Naveen-kumar14/CanScope/TASK.md

# CANScope task log

Canonical task file: `TASK.md` (no `task.md` existed; only this file is used).

## Current status

- Phase: phase 1 (repository foundation) **software-complete** as of 2026-10-13. Next phase: Stage 0/1 hardware inventory and evidence.
- Overall state: all firmware targets build, and the host and dashboard tests pass. **No hardware or protocol value is verified.** Node 3 is blocked on its pin map and role.
- Git: local repo on branch `main`, tracking `origin` = https://github.com/Naveen-kumar14/CanScope.git (see the 2026-10-13 Git entry).
- 2026-10-17: protocol v1, Node 1/2 ECU firmware, Node 3 monitor firmware (OLED/LEDs/buttons/buzzer) and the Web Serial dashboard implemented; all builds and tests pass; **not yet flashed or run on hardware**. See the 2026-10-17 entry and docs/physical-integration.md.
- 2026-10-16: physical build documentation **Rev 2.0-draft (NOT FINAL)**: canonical wiring ledger, corrected manual PDF, build video. Q1 buzzer transistor pinout BLOCKED; all other wires PROVISIONAL pending bench gates G1-G14. See the 2026-10-16 entry.

---

## 2026-10-13 — Session 1, discovery note (written before implementation)

### Repository state found

- Path: `E:\2nd year\Embedded systems Package` (used as repository root, no nested `CANScope/` folder created).
- Git: **not a Git repository** (`git status` → `fatal: not a git repository`). No commits will be made this session; `git init` is left as a user decision.
- Existing files (all preserved unchanged):
  - `CANScope_ESP32_Project_Brief.md` — project brief, status legend, candidate pin maps, test stages.
  - `CANScope_Claude_Repository_Implementation_Task.md` — repository implementation task.
  - `sketch_node1_test/sketch_node1_test.ino`
  - `sketch_node2_test/sketch_node2_test.ino`
  - `sketch_oct07a/sketch_oct07a.ino`

### What the existing sketches do (observed from source only, never run by Claude)

| Sketch | Observed behaviour | CAN settings in the source |
|---|---|---|
| `sketch_node1_test` | Installs and starts the ESP32 TWAI driver, prints success/failure. `loop()` is empty: it does not read frames, but in NORMAL mode the controller will ACK frames on the bus. | TX `GPIO17`, RX `GPIO16`, 500 kbit/s, `TWAI_MODE_NORMAL`, accept-all filter |
| `sketch_node2_test` | "Battery ECU Node 2" test transmitter. Every 1000 ms sends `0x201` (uint16 BE raw 480), `0x202` (int16 BE raw 120), `0x203` (uint8 raw 85); every 500 ms sends heartbeat `0x210` (uint8 1). Values are hard-coded constants, not sensor readings. Units/scaling are not stated anywhere. | TX `GPIO17`, RX `GPIO16`, 500 kbit/s, `TWAI_MODE_NORMAL`, standard 11-bit IDs (flags left zero) |
| `sketch_oct07a` | Serial "hello world": prints `CANScope ESP32 Ready!` every second. No CAN. | none |

Note: the sketches use GPIO17/GPIO16, while the brief's candidate map uses GPIO22/GPIO21. Neither is verified on hardware. GPIO16/17 are used for PSRAM on ESP32-WROVER modules, so the board variant matters.

### Toolchains detected

- Node.js v24.16.0, npm 11.13.0 → dashboard (Vite + React + TypeScript + Vitest planned).
- Python 3.14.2, g++ 15.2.0 (MinGW-w64), CMake 4.2.0, Ninja, mingw32-make → host-side firmware unit tests.
- **No ESP32 toolchain installed** (no arduino-cli, PlatformIO, ESP-IDF). Plan: install PlatformIO into an isolated venv in the session scratchpad (not global) and attempt ESP32 builds.

### Unverified hardware/protocol values (nothing new verified this session so far)

ESP32 board variants; transceiver part and 3.3 V compatibility; standby/silent pin wiring; Node 3 role, sensors, I/O; final CAN TX/RX GPIOs for every node; Classical CAN vs CAN FD; nominal bit rate (500 kbit/s appears in legacy sketches only); standard vs extended IDs; production CAN IDs and payloads; termination locations; dashboard transport and deployment.

### Planned scope for this session

1. Repository skeleton, `.gitignore`, README, docs (architecture, hardware status, testing, Node 3 pin map, CAN ID registry).
2. Shared firmware library (config + validation, raw frame model + serial JSON-line encoder, protocol registry/decoder, TWAI transport with TX gate, diagnostics banner) as PlatformIO libraries under `firmware/common/`.
3. PlatformIO targets: `node1`, `node2`, `node3`, `monitor`, plus `legacy` environments in node1/node2 that compile the existing sketches **unchanged** (included by path) as a regression check.
4. Host unit tests (CMake + g++) for config validation, frame model, decoder.
5. Read-only dashboard with mock data source, transport-neutral adapter, tests.
6. Run all available checks and record exact results here.

---

## 2026-10-13 — Session 1, implementation results

### Summary

Built the phase-1 foundation around the existing work: shared firmware libraries, four PlatformIO targets plus regression builds of the two legacy sketches, host unit tests, a read-only mock-data dashboard, and documentation. Every software check passes. Nothing hardware-related was tested.

### Work completed

- Repository skeleton, `.gitignore` (build outputs, secrets, `captures/private/`), `README.md`.
- `firmware/common` libraries:
  - `can_config`: config model and validation.
  - `frame_capture`: `RawFrame` and a bounded JSON-line encoder.
  - `can_transport`: interface, TX gate, status JSON, and `TwaiTransport` for ESP32 (listen-only/normal/no-ack, alerts, error counters, bus-off counting, explicit-only recovery).
  - `protocol_decoder`: empty production registry, plus the UNVERIFIED legacy test-sketch registry.
  - `diagnostics`: start-up banner.
  - `node_runtime`: shared ESP32 setup/loop.
- Targets:
  - `firmware/node1` (`node1`, `legacy_sketch`) and `firmware/node2` (`node2`, `legacy_sketch`): normal mode, TX disabled.
  - `firmware/node3` (`node3`): all CAN values UNVERIFIED, so it refuses to start CAN. Has placeholder sections for sensors, inputs, outputs and application messages.
  - `firmware/monitor` (`monitor`): listen-only, TX disabled.
- Host tests (`test/`, CMake + g++ with `-Werror`): config validation, raw frame/JSON, TX gate/status, banner, decoder (EXAMPLE data).
- Dashboard (`dashboard/`, Vite 8 + React 19 + TS 6 + Vitest 5 + ESLint 10):
  - transport-neutral `CanDataSource` (no send method)
  - mock source with 6 scenarios
  - serial-line parser for the firmware JSON lines
  - decoder (decoded/unverified/unknown/mismatch)
  - status bar with READ-ONLY and MOCK badges
  - bus summary (state, frame rate, RX/TX/error/bus-off/missed counters)
  - node health cards (Node 3 included)
  - filters (ID, node, time range)
  - frame table and frame detail
  - loading/empty/stale/disconnected/error states
- Docs: `docs/architecture.md`, `docs/hardware-status.md`, `docs/testing.md`, `docs/wiring/node-3-pin-map.md`, `docs/protocol/can-id-registry.md`, `dashboard/README.md`, `tools/README.md`, `test/integration/README.md`.
- Tools: `tools/run-host-tests.sh`, `tools/build-firmware.sh`.

### Files changed

All new (nothing existing was modified): `.gitignore`, `README.md`, `TASK.md`, `captures/.gitkeep`, `docs/**`, `firmware/**`, `dashboard/**` (excluding `node_modules`/`dist`), `test/**`, `tools/**`.

### Existing files preserved (unchanged; SHA-256 recorded 2026-10-13 after the session's work)

```
47a1f6f909a73373c137a00b1bbfa89a24ec637cac8b219b4166601a146bd248  sketch_node1_test/sketch_node1_test.ino
cb46f039dfccee47f8f14869fbaa3764d24421f23439c87085f605a9f451ec76  sketch_node2_test/sketch_node2_test.ino
9d1d708889231af702a1911dbd04e29093a731fc3bfaa9fa46c486f1d1901289  sketch_oct07a/sketch_oct07a.ino
56087058ca20f9494d81bf489a96d00ede10a9634ad793d4a30d34e5812a5fe8  CANScope_Claude_Repository_Implementation_Task.md
5dd6150b1daaee2500ad7d59633bb8cc32688d90ea1ffb959424b24a40516052  CANScope_ESP32_Project_Brief.md
```

Hashes were not taken before the session. No tool in this session wrote to these files; they were only read, or `#include`d by the legacy build wrappers.

### Environment changes outside the repository

- PlatformIO Core 6.2.0 installed in a venv in the Claude session scratchpad (temporary; not on the user's PATH).
- PlatformIO packages (espressif32 6.12.0, Arduino-ESP32, xtensa toolchain) downloaded to **`C:\canscope-pio`** (`PLATFORMIO_CORE_DIR`). The first attempt, with the core dir inside the long scratchpad path, failed with `PackageException: Could not install package 'espressif32 @ 6.12.0'` because unpacked paths exceeded the Windows 260-character limit. `C:\canscope-pio` is safe to delete; PlatformIO will download again.
- `dashboard/node_modules` installed by `npm install` (ignored by git).

### Commands and exact results

| Command | Result |
|---|---|
| `sh tools/run-host-tests.sh` (clean `build/host-tests`) | **5/5 test suites passed** (test_can_config, test_raw_frame, test_can_transport, test_diagnostics, test_protocol_decoder). Compiled with `-Wall -Wextra -Werror` |
| `pio run -d firmware/node3 -e node3` (first build) | SUCCESS. One `-Wcomment` warning in `node3_hw_config.h` (trailing backslash in a comment), fixed afterwards |
| `sh tools/build-firmware.sh` (`PLATFORMIO_CORE_DIR=C:/canscope-pio`) | **6/6 SUCCESS, 0 warnings in project sources**: node1/node1, node1/legacy_sketch, node2/node2, node2/legacy_sketch, node3/node3, monitor/monitor. Shared-runtime targets: RAM 6.6% (21,648 B), flash 21.5% (~281 KB). Legacy: RAM 6.6%, flash 20.8–20.9% |
| First `sh tools/build-firmware.sh` attempt | exit 127 `pio: command not found`. My PATH used `C:/...` form, which POSIX PATH can't parse. Not a script defect |
| `npm run check` (dashboard) | typecheck OK, eslint OK, **Vitest 34/34 passed (5 files)**, `vite build` OK (JS 241 kB / 75 kB gzip) |
| First Vitest run | 1 failure in the read-only test: its regex matched the footer disclaimer text. Test rewritten to assert the exact set of interactive controls (no buttons/links/forms; one ID textbox, two selects); passes |
| `npx vite --port 5173` + `curl` | `/`, `/src/main.tsx`, `/src/pages/DashboardPage.tsx`, `/src/mock-data/mock-source.ts` returned HTTP 200 and `<title>CANScope Monitor</title>`. Server stopped afterwards |
| Visual browser check | **Not done**: Claude-in-Chrome extension not connected. Rendering is covered only by jsdom tests |

### Hardware or protocol values newly verified

None.

### Assumptions that remain (see docs/hardware-status.md)

- `esp32dev` (classic ESP32) is the board for every node: WORKING_ASSUMPTION.
- node1/node2/monitor use TX GPIO17 / RX GPIO16 at 500 kbit/s: WORKING_ASSUMPTION, copied from the legacy sketches. GPIO16/17 conflict with PSRAM on WROVER modules, and the firmware warns about this.
- Node 3 GPIOs and bit rate: UNVERIFIED. The firmware refuses to start CAN.
- Classical CAN only (ESP32 TWAI limitation); actual bus requirement unknown.
- Legacy IDs 0x201/0x202/0x203/0x210 are test traffic with unknown units: UNVERIFIED.
- `sourceNode` means the capturing node. The sender is not knowable from a CAN frame.

### Blockers

- **Node 3 hardware**: no schematic, component list or photos, so the pin map, sensors and outputs can't be filled in. Exact cause: the information isn't in the repository or the brief.
- **Transceiver identity**: the part number is unknown, so 3.3 V compatibility and STB/RS wiring can't be confirmed.
- **Production protocol**: no specification or capture exists.
- **Git**: the folder is not a repository. Commits were not made; this is a user decision.

### Future tasks (recorded, not started)

1. Loopback self-test env (`NoAck` + TWAI self-reception, `ENABLE_TX=true`) for bring-up stage 3.
2. Host serial-to-WebSocket bridge plus a live `CanDataSource` adapter, using `parseSerialLine()`.
3. Bus-off recovery policy (currently report-only; `request_bus_off_recovery()` exists but is never called).
4. Port node2's test traffic into the new `node2` target behind an explicit, documented test env, if still wanted.
5. Any dashboard command feature needs a separate approved specification (see `docs/architecture.md#out-of-scope`).

### Next concrete action

The user should identify (photo or part number) each ESP32 module and the CAN transceiver module, and share the Node 3 component list or schematic. With that, fill `docs/hardware-status.md` and `docs/wiring/node-3-pin-map.md`, then run bring-up stages 1–2 (power/continuity, about 60 Ω CANH–CANL check) and record the measurements here.
Optional, in the repo: `git init` and a first set of focused commits, if the user approves. *(Done; see the next entry.)*

---

## 2026-10-13 — Session 1, Git repository and GitHub remote

### Summary

The user asked for a repository under the GitHub account `Naveen-kumar14`, and then created `https://github.com/Naveen-kumar14/CanScope.git` themselves. The local folder is now a Git repo pushed to it.

### Work completed

- `git init -b main` in the project root. Author identity is the existing global git config (Naveen Kumar).
- Before committing, checked that `.gitignore` excludes `build/`, `dashboard/node_modules/`, `dashboard/dist/` and `firmware/*/.pio/`, and grepped the 91 files for secret keywords (password/ssid/api key/token/private key). The only hits were policy text, never actual secrets.
- Focused commits:
  `ae9c146` chore: add existing CANScope brief, task spec and test sketches ·
  `2a51dcc` chore: create CANScope repository structure ·
  `4cd36cd` firmware: add shared CAN transport foundation ·
  `5a0ee74` firmware: scaffold node1, node2, Node 3 and monitor targets ·
  `bcd671a` test: add host unit tests for portable firmware code ·
  `9ee99ff` dashboard: add read-only CAN monitoring shell with mock data and tests ·
  `b72ffdd` docs: record hardware assumptions and verification gates ·
  `2571078` docs: add TASK.md session log ·
  `2dfe591` chore: keep shell scripts LF-only (`.gitattributes`: `* text=auto`, `*.sh text eol=lf`).
- `git remote add origin https://github.com/Naveen-kumar14/CanScope.git`. `git ls-remote origin` returned no refs (an empty repo), so nothing could be overwritten.
- `git push -u origin main` → `* [new branch] main -> main`, `branch 'main' set up to track 'origin/main'`.

### Notes

- The GitHub CLI was not installed. `winget install GitHub.cli` was started but stopped once the user supplied the repo URL, and `C:\Program Files\GitHub CLI\gh.exe` is not present. The push used Git Credential Manager.
- The original sketches and briefs are committed unchanged (commit `ae9c146`).

### Next concrete action

Unchanged: hardware inventory (ESP32 modules, transceiver part number, Node 3 component list or schematic), then bring-up stages 1–2. From now on, work is committed in small commits and pushed to `origin/main`.

---

## 2026-10-16 — Physical build: manual audit, Rev 2 manual, build video

### Summary

Audited `CANScope_Physical_Build_Manual.pdf` (Rev 1.0) against the repository and manufacturer datasheets. Created one canonical wiring ledger, and generated from it a corrected manual (Rev 2.0-draft), wiring diagrams, a 60-minute narrated build video, and validation records. **No hardware was inspected, measured or powered.** The documents are labelled NOT FINAL.

### Work completed

- `docs/wiring/pin_ledger.json`: canonical wiring contract with 59 connections, 5 conditional rows and 14 bench gates (G1-G14). Statuses: 54 PROVISIONAL, 5 BLOCKED (Q1 transistor pinout), 0 CONFIRMED.
- `tools/hwdocs/`: ledger loader and safety validator, diagram renderer, PDF builder, cross-checker.
- `docs/wiring/diagrams/*.png` (9 sheets) and `docs/CANScope_Physical_Build_Manual_Rev2.pdf` (23 pages, sections 0-19).
- `video/source/` (storyboard and renderer), `video/CANScope_Physical_Build_Demo.mp4` (59:57, 1080p30, chapters), `.srt`, `storyboard.md`, `narration.md`.
- `validation/correction_register.md` (27 entries), `validation/wire_coverage_checklist.md` (generated), `validation/final_review.md`.

### Key decisions (PROVISIONAL until the bench gates pass)

- Node 3 CAN TX/RX = GPIO17/16, the same as Nodes 1/2 and the `monitor` firmware. The brief's 22/21 collided with the Arduino-ESP32 default I2C SDA 21 / SCL 22 (`pins_arduino.h`).
- Node 3 peripherals: OLED SDA 21 / SCL 22; LEDs 25/26/27, each with its own 220 Ohm; buttons 32/33 (internal pull-up, diagonal legs); buzzer drive GPIO13 -> 1k -> NPN low side, 10k base pull-down, buzzer + from Node 3 VIN. No external 5 V.
- Bus order: end A - N1 - N2 - N3 - end B. RT1 at TRX1, RT2 at TRX3, subject to the onboard-terminator check G6.
- Node 3 hardware runs `firmware/monitor` for bring-up (`firmware/node3` refuses to start CAN by design).
- Flash each bare board before wiring.

### Evidence used

TI SN65HVD23x datasheet SLOS346O; Espressif ESP32 datasheet; Espressif ESP32-WROOM-32 datasheet v3.8 (downloaded and text-extracted); local `framework-arduinoespressif32/variants/esp32/pins_arduino.h`; repository firmware sources. A grep of `firmware/` found no use of the peripheral GPIOs.

### Commands and results

| Command | Result |
|---|---|
| `python tools/hwdocs/ledger.py` | 8/8 firmware CAN GPIO bindings agree with the ledger; no structural problems |
| Ledger negative tests (CANH->GPIO, GPIO->buzzer, joined 3V3, VIN->3V3, strapping pin, third terminator) | Each was rejected as expected |
| `python tools/hwdocs/validate.py` | **17/17 PASS** (diagram <-> ledger <-> video <-> firmware; gates before use; power off on every wiring step) |
| `python tools/hwdocs/build_manual.py` | PDF written; all 23 pages rasterized and visually reviewed |
| `python video/source/render_video.py` | MP4 written: 59:57, H.264 1920x1080 30 fps + AAC, 10 chapters; audio mean -20.8 dB; frames extracted from the MP4 spot-checked. The full 60 minutes was not watched end to end |
| Environment | Python venv in the session scratchpad (pillow 12.3.0, reportlab 5.0.1, imageio-ffmpeg 0.6.0, pypdf, pypdfium2); Windows SAPI voice Microsoft Zira |

Two earlier full renders were stopped on purpose, to pick up diagram text fixes and add chapters. Only the final render is kept.

### Hardware or protocol values newly verified

None. Datasheet facts were used for design; no physical value is verified.

### Blockers

- Q1 part number and its E/B/C order (gate G10): blocks N3-28 to N3-32 and, through them, N3-35.
- If Node 2's transceiver has an onboard 120 Ohm (gate G6), row C-T2 is blocked until it is removed.
- No firmware exists for the OLED, LEDs, buttons, buzzer, motor/battery simulation or fault injection.

### Next concrete action

The user photographs each ESP32 shield and both headers (G1, G2) and each transceiver front and back (G4), measures the onboard CANH-CANL resistance of each bare module (G6), and reads the transistor marking (G10). Then update the ledger statuses and run bench stages per manual sections 15-17. The MP4 is gitignored (94 MB); decide whether to publish it via Git LFS or a GitHub release.

---

## 2026-10-17 — Physical hardware software: protocol v1, ECU and monitor firmware, Web Serial dashboard

### Request and approval

The user asked for the complete software for the three-board physical model:

- Node 1 Motor ECU and Node 2 Battery ECU transmitting telemetry and heartbeats, with validated commands and demo faults
- the Node 3 monitor with independent detection and the OLED/LED/button/buzzer peripherals
- USB serial integration and a dashboard with working controls

This is the explicit approval the earlier architecture asked for before any command feature (`docs/architecture.md`, "Extension point"). The user also said not to touch the manual, wiring diagrams, video, subtitles or doc tools; none of those files was modified.

### Decisions

- **One protocol source:**
  - `protocol/canscope_protocol.json`. `tools/protocol/gen_protocol.py` generates `protocol_spec.h`, `protocol-spec.generated.ts`, and C++ and TS golden vectors; `--check` runs in `tools/run-host-tests.sh`.
  - IDs: 0x120 motor, 0x220 battery, 0x701/0x702 heartbeats. These avoid the legacy 0x201-0x210, and the generator enforces that.
  - DLC 8 BE with a byte 6 counter and a byte 7 checksum. 500 kbit/s, standard IDs. Spec: `docs/protocol/canscope-protocol-v1.md`.
- **Node 3 firmware = `firmware/monitor`**, as the ledger, manual and `ledger.py` already assume. `firmware/node3` is left unchanged and must not be flashed on Node 3.
- **Monitor CAN mode:**
  - Changed from listen-only to normal mode with `ENABLE_TX=false`, so it ACKs frames. Without that, a single ECU on the bus cannot be tested.
  - `-DMONITOR_LISTEN_ONLY=1` restores listen-only.
- **Bus-off recovery:**
  - Still never automatic. It is operator-triggered by serial `recover` or Node 3 button B long press.
  - `TwaiTransport` now restarts the controller after a requested recovery completes.
- **Serial at 460800 baud** for all CANScope nodes (monitor traffic is about 9 KB/s). Legacy sketches stay at 115200.
- **Commands reach each ECU over its own USB port.** Node 3 detects faults only from the bus.
  - The dashboard keeps "observed by Node 3" separate from "ECU self-report".
- **Dashboard bridge = Web Serial** (Chrome/Edge on localhost). There is no separate process or native module.
  - Without Web Serial, physical mode shows an error and never falls back to mock data.
- **Buzzer disabled by default:** gate G10 (the Q1 pinout) is BLOCKED.
  - Env `monitor_buzzer` enables it after G10.
  - GPIO13 only drives Q1's base through 1 kOhm, as in the ledger.
- **Adafruit SSD1306 2.5.13 / GFX 1.12.1 / BusIO 1.17.1**, pinned for the OLED. The address is probed at 0x3C/0x3D; the monitor retries every 10 s if absent.

### Files

New:
- `protocol/canscope_protocol.json`, `tools/protocol/gen_protocol.py`
- `firmware/common/{canscope_protocol,serial_link,ecu_core,ecu_runtime,monitor_core,monitor_ui}/`
- `test/protocol/test_can_protocol.cpp`, `test/firmware_host/test_{serial_link,ecu_core,monitor_core,monitor_ui}.cpp`, generated vector headers
- `dashboard/src/lib/{protocol.ts,protocol-spec.generated.ts}`, `dashboard/src/lib/serial/*`
- `dashboard/src/components/{ConnectionPanel,TelemetryPanel,FaultPanel,ControlPanel,SelftestCard}.tsx`
- dashboard tests `{protocol,serial-utils,serial-line-parser-v1,dashboard-state-v1,physical-source,DashboardPhysical}.test.*`, `fake-serial.ts`
- `docs/protocol/canscope-protocol-v1.md`, `docs/physical-integration.md`

Changed:
- `firmware/node1|node2` (`main.cpp`, configs: TX enabled, 460800)
- `firmware/monitor` (full Node 3 firmware, platformio.ini with lib_deps and `monitor_buzzer`)
- `firmware/common/can_transport/twai_transport.*` (recovery restart, TX queue 8)
- `firmware/common/frame_capture/json_writer.*` (signed, scaled and nested objects)
- `test/CMakeLists.txt`, `tools/run-host-tests.sh`, `tools/build-firmware.sh`
- dashboard `events.ts`, `serial-line-parser.ts`, `dashboard-state.ts`, `data-source.ts`, `use-can-scope.ts`, `protocol-registry.ts`, `decoder.ts`, `App.tsx`, `DashboardPage.tsx`, `StatusBar.tsx`, `StateBanner.tsx`, `FrameTable.tsx`, `styles.css`, and two existing tests (the old "no controls" assertion and the empty production registry)
- docs: `README.md`, `dashboard/README.md`, `docs/architecture.md`, `docs/testing.md`, `docs/hardware-status.md` (Node 3 / dashboard rows), `docs/protocol/can-id-registry.md`, `tools/README.md`

The node1/node2/monitor config headers were rewritten as UTF-8; they were Windows-1252. The `#define ..._CAN_TX/RX_GPIO` lines that `ledger.py` parses were kept.

### Environment

- PlatformIO Core 6.1.18 installed in `C:\canscope-pio\penv`. The earlier scratchpad venv was gone; packages were already cached in `C:\canscope-pio`.
- PlatformIO downloaded the Adafruit libraries. The dashboard needed no new npm dependency.

### Commands and exact results

| Command | Result |
|---|---|
| `python tools/protocol/gen_protocol.py --check` | `protocol generated files up to date (4 files)` |
| `sh tools/run-host-tests.sh` | exit 0. **10/10 suites passed** (5 existing + test_can_protocol 191 checks, test_serial_link 49, test_ecu_core 1786, test_monitor_core 216, test_monitor_ui 119). `-Wall -Wextra -Werror` |
| First runs of the new host tests | `-Wformat-truncation` in a monitor detail string (shortened); a shadowed variable in a test; a wrong hand-computed checksum in a test (222, not 221). All fixed |
| `sh tools/build-firmware.sh` (`PLATFORMIO_CORE_DIR=C:\canscope-pio`) | exit 0. **7/7 SUCCESS**: node1, node1/legacy_sketch, node2, node2/legacy_sketch, node3, monitor, monitor_buzzer. **0 `warning:` lines** in the whole log. node1/node2: RAM 6.7 %, flash 22.5 %. monitor: RAM 9.0 %, flash 25.3 % |
| `python tools/hwdocs/ledger.py` (read-only check) | 8/8 firmware CAN GPIO bindings OK, no structural problems |
| `cd dashboard && npm run check` | exit 0: tsc OK, eslint OK, **Vitest 69/69 passed (11 files)**, vite build OK (JS 295 kB / 90 kB gzip) |
| First dashboard runs | 6 existing tests failed by design (old read-only assertion, renamed badge, v1 registry, event batching) and were updated. 3 new physical-source tests exposed lazily published acks/hellos, now published at once. A tsc error (`setImmediate` type) was fixed with a MessageChannel hop |
| `npx vite --port 5179` + curl | `/`, `/src/main.tsx`, `/src/lib/serial/physical-source.ts`, `/src/components/ControlPanel.tsx` all HTTP 200. Server stopped |
| Visual browser check | **Not done**: Claude-in-Chrome extension not connected |

### Hardware or protocol values newly verified

None. Nothing was flashed. No CAN frame, serial line from a real board, OLED, LED, button or buzzer was observed. Compilation and host tests prove only build and logic correctness.

### Remaining software limitations

- Web Serial only: no Firefox/Safari support, and no access from another PC on the LAN.
- The monitor drops raw `frame` lines only if USB cannot keep up; `frames off` is the manual fallback.
- The fault snapshot lists at most 10 active faults per line (flagged `truncated`).
- Physical bus-off cannot be forced from software; it is only observed and recovered.
- `drive` profile values are deterministic waves, not physical models.

### Next concrete action

1. Flash the three bare boards (`docs/physical-integration.md` sections 3-5) and confirm each one's banner, `hello` and a `@t1 help` ack.
2. With the bench gates passed, run bring-up A/B/C (section 7) and save the first protocol v1 capture to `captures/`.
3. Then work through the section 8 fault table and record the results here.

---

## 2026-10-23 — Dashboard UX redesign, validation and serial lifecycle fixes, CAN link diagnosis

### Summary

The user reported that all three USB serial ports open and ECU commands are acknowledged, but Node 3 shows `N1 HB: LOST` / `N2 HB: LOST`, the dashboard frame rate and monitor RX count stay 0, ECU transmit failures rise, and CANH–CANL measures about 57–62 Ω. Node 1 and Node 2 both run in normal mode and would acknowledge each other's frames, so both failing means the fault is common to the bus wiring, not only Node 3. Code cannot fix that, so a start-up transceiver echo check and a plain-language CAN link diagnosis were added to locate it. Confirmed software defects were fixed with regression tests, and the dashboard was reorganised into tabs.

### Confirmed defects fixed (each with a regression test that fails on the old code)

- **Status lines defaulted missing counters to 0** (`serial-line-parser.ts`): every status field is now required and typed; a missing counter makes the line invalid.
- **Frames with an impossible DLC/payload were accepted** (DLC 8 with 4 bytes, data on a remote frame, missing `identifierFormat` silently read as standard): rejected now. DLC 9–15 with 8 bytes stays valid for classical CAN.
- **A port lost on unplug was never closed** (`serial-link.ts`): per the Web Serial spec it stays "opened", so the automatic reopen after replug hit `InvalidStateError`. The lost port is now released. The fake port in the tests now follows the spec.
- **Stale async `open()` continuations could change the current state** (Disconnect + Connect while a port was opening left two handles and two readers): there is now one generation counter, and port open/close calls are serialised.
- **`forgetPort` always reported success**: it now reports `revoked` / `unsupported` / `failed`, and the UI shows that.
- **Command acks were matched only by id and node**: they are now also bound to the serial link and the device boot. Session tags went from 3 `Math.random` base-36 characters to 6 `crypto.getRandomValues` characters.
- **Fault list stayed "No active faults" after Node 3 was unplugged**, and a stale list could tick a requested fault as "detected": both now show *unknown*. "No active faults" waits for the first fault list.
- **Firmware status line buffer (384 B) was smaller than the worst-case line (~500 B)**: `encode_status_json` would return 0 and silently drop the line. Raised to 640 B in the ECU, monitor and node3 runtimes; host test added.
- Mock mode said its generated frames were "captured by Node 3"; the wording now depends on the mode. The idle physical header said "PHYSICAL · LIVE" in green; it is now a neutral badge plus "USB: n of 3 boards".

### Added

- Firmware: `can_transport/transceiver_check.{h,cpp}` (portable classifier, host-tested) and a start-up echo check in `TwaiTransport::begin()` (skipped in listen-only). It drives TX for 8 × ~6 µs and reads RX with pull-up/pull-down. The result appears in the banner (`# CAN transceiver echo check: ...`) and as `transceiverCheck` in every `status` line. It does not test CANH/CANL or termination.
- Dashboard: tabs (Overview, Live CAN data, Fault testing, Connections, Diagnostics; WAI-ARIA keyboard pattern; URL hash), system status strip, CAN link check (`lib/bus-diagnosis.ts`), a controller table with the transceiver echo result, and status icons (shape + text, never colour alone).

### Commands and exact results

| Command | Result |
|---|---|
| `cd dashboard && npm run check` | exit 0: tsc OK, eslint OK, **Vitest 98/98 (12 files)**, vite build OK (JS 316 kB / 96 kB gzip). Baseline before the work: 76/76 |
| `sh tools/run-host-tests.sh` | `protocol generated files up to date (4 files)`; **10/10 suites passed** (test_can_transport 27 checks, was 7) |
| `sh tools/build-firmware.sh` (`PLATFORMIO_CORE_DIR=C:/canscope-pio`) | exit 0, **7/7 SUCCESS**, no `warning:` lines. Monitor flash 25.4 % |
| Headless Chrome (DevTools protocol) on the dev server and `vite preview` | every tab at 1440 px and 390 px (mobile emulation): no horizontal overflow, no console errors; keyboard Tab/ArrowRight focus verified visually |

The Claude-in-Chrome extension was not connected; headless Chrome was used instead. No Web Serial port could be opened in headless mode, so physical mode was checked only in its unconnected state.

### Hardware or protocol values newly verified

None. No board was available to this session. The symptoms above are as reported by the user.

### Next concrete action

Flash the new `node1`, `node2` and `monitor` builds and read each board's `# CAN transceiver echo check:` line (or the Diagnostics tab). Then follow `docs/physical-integration.md` section 9: a failing check names that board's TX/RX/Rs/power wiring; if all three pass, check CANH↔CANH and CANL↔CANL continuity between the modules and confirm there is no CANH–CANL short.
