Naveen-kumar14/CanScope/video/narration.md

# CANScope physical build video: narration script

Generated by `video/source/render_video.py` from `video/source/scenes.py` and `docs/wiring/pin_ledger.json` (Rev 2.0-draft). Total length 00:59:57.079.
Voice: Windows SAPI (Microsoft Zira). Timestamps are the start of each sentence in the MP4.

## Scene 1: Introduction and safety

**Step 1 - Title**

- `00:00:00.000` This video shows how to build the three CANScope nodes, one connection at a time.
- `00:00:06.474` Every picture is a schematic illustration generated from the project's pin ledger.
- `00:00:12.407` It is not a photograph of your modules, so always read the labels printed on your own parts.
- `00:00:19.415` Pause the video whenever you need to. Each step stays on screen until its narration ends.
**Step 2 - Architecture**

- `00:00:28.344` Node one is the motor ECU simulator. Node two is the battery ECU simulator.
- `00:00:35.802` Node three is the CANScope monitor, with an OLED display, three status LEDs, two buttons and a buzzer.
- `00:00:44.670` Each ESP32 talks to the bus through its own SN65HVD230 transceiver.
- `00:00:52.529` The bus is one straight line: end A, Node one, Node two, Node three, end B.
- `00:01:00.922` There is a 120 ohm terminator at each physical end, and nowhere else.
**Step 3 - What is and is not verified**

- `00:01:08.911` Here is the honest status.
- `00:01:11.890` No board, module or wire in this video has been physically inspected or measured.
- `00:01:18.204` Most connections are provisional. You may make a provisional connection only after the bench checks, called gates, listed for it have passed.
- `00:01:28.877` The buzzer transistor connections are blocked, because the transistor part number is not known yet.
- `00:01:36.335` The current firmware only brings up CAN. It does not drive the OLED, LEDs, buttons or buzzer, and it does not simulate the motor or battery or inject faults yet.
- `00:01:49.743` So this video builds and checks the hardware. It does not claim the peripherals work.
**Step 4 - Inventory**

- `00:01:58.211` Here is the inventory. Three ESP32 DevKit V1 thirty-pin boards and three SN65HVD230 transceiver modules.
- `00:02:09.779` One SSD1306 I2C OLED, three LEDs, three 220 ohm resistors, two 120 ohm resistors, two buttons and one five volt active buzzer.
- `00:02:24.726` Two breadboards, jumper wires and three USB data cables.
- `00:02:30.255` You must add an NPN transistor and a one kilo-ohm base resistor. They are needed so that the buzzer is never driven directly by a GPIO pin.
- `00:02:41.127` You also need a digital multimeter. Every gate in this video uses it.
- `00:02:47.426` A ten kilo-ohm pull-down is recommended, and a 1N4148 diode is needed only if your buzzer is electromagnetic.
**Step 5 - Safety**

- `00:02:57.714` Safety rules. Unplug every USB cable before you wire, measure resistance, or change anything.
- `00:03:07.132` There is no external five volt supply in this build.
- `00:03:11.521` Never connect CAN high or CAN low to an ESP32 pin. Only the transceiver touches the bus.
- `00:03:19.929` Never put five volts on a three volt three pin, and never join the three volt three pins of two different nodes.
- `00:03:27.887` Never drive the buzzer straight from a GPIO pin.
- `00:03:32.461` This is a bench simulator. Never connect it to a vehicle or to a real network.
- `00:03:39.100` If a step is marked blocked, stop. Do not guess.
**Step 6 - Status legend and gates**

- `00:03:46.463` Every wiring step shows a wire number, where it starts, where it ends, the signal and the status.
- `00:03:54.647` Confirmed means a named document supports it. You still read the printed labels.
- `00:04:01.300` Provisional means you must first pass the listed gates. Gates are short bench checks, numbered G1 to G14.
- `00:04:10.878` Blocked, shown as a dashed red line, means do not wire it.
- `00:04:16.817` Write every gate result on the sign-off sheet in the manual.
**Step 7 - Flash before wiring**

- `00:04:22.811` Before any wire, flash each bare board, with nothing connected except its USB cable.
- `00:04:30.164` A new board may already run unknown firmware that drives random pins, which could fight the transceiver later.
- `00:04:38.117` Node one gets the node1 firmware. It listens in normal mode and acknowledges frames, but does not transmit.
- `00:04:47.816` Node two gets the legacy test sketch. It is the only firmware that transmits, sending fixed test frames.
- `00:04:57.209` Node three gets the monitor firmware, which is listen-only.
- `00:05:02.377` All three use GPIO seventeen for CAN transmit and GPIO sixteen for receive, at 500 kilobits per second, matching the ledger.
- `00:05:13.665` Unplug the board, then label it Node one, two or three.

## Scene 2: Identify the hardware

**Step 8 - ESP32 pin locator**

- `00:05:20.469` Hold each ESP32 with the components up and the USB connector pointing left.
- `00:05:27.292` Gate G1: read the marking on the metal shield. It must say ESP-WROOM-32, not WROVER. On a WROVER, GPIO sixteen and seventeen are used by memory and cannot be CAN pins.
- `00:05:42.945` Gate G2: read all thirty pin labels. Pin one of each header is the pin next to the USB connector.
- `00:05:51.728` The top row in these diagrams is the VIN side. The bottom row is the 3V3 side.
- `00:05:59.157` If your labels are in a different order, stop and send a photo. Do not count pins from the drawing.
- `00:06:07.220` Pins shaded dark red are flash, strapping or USB serial pins. CANScope never uses them.
**Step 9 - Transceiver identity**

- `00:06:17.568` This is the SN65HVD230 transceiver, marked VP230 on the chip.
- `00:06:25.571` Gate G4: check the chip marking, and check that the module's supply pin is labelled 3V3 or VCC with no five volt marking. The chip runs from three point zero to three point six volts.
- `00:06:40.643` CTX, also called TXD or D, is the transmit input. It connects to the ESP32 transmit pin. This is not crossed like a UART.
- `00:06:54.326` CRX, also called RXD or R, is the receive output. It connects to the ESP32 receive pin.
- `00:07:04.915` Gate G5 checks the Rs mode pin. It must be pulled to ground for high-speed mode. If it is high, the chip is in standby and cannot transmit or acknowledge.
- `00:07:17.642` If your module exposes a pin labelled RS, S or STB, wire it to ground. Leave Vref unconnected.
**Step 10 - Onboard termination**

- `00:07:28.546` Gate G6: many of these modules already have a 120 ohm resistor between CAN high and CAN low.
- `00:07:36.988` With the module unpowered and connected to nothing, measure CAN high to CAN low.
- `00:07:42.987` Above ten kilo-ohms means no onboard terminator. About 120 ohms means there is one.
- `00:07:51.335` If the Node one or Node three module has one, leave out that end's external resistor.
- `00:07:58.029` If the Node two module has one, stop. That resistor must be removed, so send a photo first.
- `00:08:07.177` The aim is exactly two terminators on the whole bus.
**Step 11 - OLED and LEDs**

- `00:08:13.121` Gate G7: read the four OLED labels. G N D, V C C, S C L, S D A is common, but some modules swap ground and V C C. Always connect by the printed name.
- `00:08:28.869` The OLED is powered from three volt three only, so its pull-ups keep the data lines at three volt three.
- `00:08:36.842` Gate G9: the LED's long leg is the anode. The short leg, next to the flat edge, is the cathode. Confirm with the meter's diode test.
**Step 12 - Buttons and resistors**

- `00:08:50.760` Gate G8: on a four-leg button, two diagonally opposite legs are always on different contacts, whichever way you turn it.
- `00:09:00.343` Check with the meter. The diagonal legs must be open when released and closed when pressed.
- `00:09:07.602` Gate G13: measure every resistor before you insert it. Colour bands are easy to misread.
**Step 13 - Buzzer and transistor**

- `00:09:17.280` Gate G11: confirm the buzzer is active, rated five volts, takes thirty milliamps or less, and find its plus leg.
- `00:09:27.788` Gate G10: the transistor is blocked. Different transistors have different leg orders. For example, the PN2222A is emitter, base, collector, but the BC547 is collector, base, emitter.
- `00:09:46.900` Read your transistor's marking and look up its own datasheet. Until that is recorded, the transistor connections stay blocked.
**Step 14 - Unresolved items**

- `00:09:57.993` Before wiring, record or photograph these items.
- `00:10:02.582` The ESP32 shield marking and headers, both sides of each transceiver, the onboard terminator reading, the OLED labels, the transistor part number and the buzzer details.
- `00:10:16.179` The transistor item is blocked until you supply it.

## Scene 3: Assemble Node 1 - Motor ECU

**Step 15 - Place ESP1 and TRX1**

- `00:10:21.783` Node 1 goes on breadboard A. Seat ESP1 across the centre trench in columns 1 to 15.
- `00:10:29.941` Gate G3: every pin must still have at least one free hole beside it on both sides. If not, do not force it.
- `00:10:39.879` Place TRX1 in the lower half, around columns 18 to 24.
- `00:10:46.428` Everything stays unplugged.
**Step 16 - Node 1 pin plan**

- `00:10:50.867` Node 1 uses only four ESP32 pins, all on the 3V3-side header.
- `00:10:58.091` Three volt three, ground, RX2 which is GPIO sixteen, and TX2 which is GPIO seventeen.
- `00:11:08.064` Every other pin stays empty.
**Step 17 - N1-01**

- `00:11:12.543` Connection N1-01.
- `00:11:16.213` Take a red jumper.
- `00:11:18.692` One end goes to ESP1 pin 3V3: the first pin from the USB end on the 3V3 side header.
- `00:11:27.445` The other end goes to the TRX1 pin printed 3V3.
- `00:11:32.739` Signal: 3V3_N1.
- `00:11:37.328` Status: provisional. Make it only after gates G1, G2 and G4 have passed and you have recorded the results.
- `00:11:47.541` Check: Power off: continuity ESP1 3V3 pin to TRX1 3V3 pin; no continuity to any GND or 5 V point.
**Step 18 - N1-02**

- `00:12:01.319` Connection N1-02.
- `00:12:04.963` Take a black jumper.
- `00:12:07.547` One end goes to ESP1 pin GND: the second pin from the USB end on the 3V3 side header.
- `00:12:15.856` The other end goes to the TRX1 pin printed GND.
- `00:12:20.700` Signal: GND.
- `00:12:23.644` Status: provisional. Make it only after gates G2 and G4 have passed and you have recorded the results.
- `00:12:32.967` Check: Continuity ESP1 GND to TRX1 GND.
**Step 19 - N1-03**

- `00:12:40.381` Connection N1-03.
- `00:12:44.110` Take a white jumper.
- `00:12:46.614` One end goes to ESP1 pin TX2, GPIO 17: the seventh pin from the USB end on the 3V3 side header.
- `00:12:57.522` The other end goes to the TRX1 pin printed CTX.
- `00:13:02.891` Signal: CAN_TX_N1 (GPIO17).
- `00:13:08.725` Status: provisional. Make it only after gates G1, G2 and G4 have passed and you have recorded the results.
- `00:13:18.938` Check: Continuity TX2 pin to CTX pin; NOT to CRX.
**Step 20 - N1-04**

- `00:13:27.677` Connection N1-04.
- `00:13:31.401` Take a brown jumper.
- `00:13:33.985` One end goes to ESP1 pin RX2, GPIO 16: the sixth pin from the USB end on the 3V3 side header.
- `00:13:44.609` The other end goes to the TRX1 pin printed CRX.
- `00:13:49.898` Signal: CAN_RX_N1 (GPIO16).
- `00:13:55.486` Status: provisional. Make it only after gates G1, G2 and G4 have passed and you have recorded the results.
- `00:14:05.699` Check: Continuity RX2 pin to CRX pin; NOT to CTX.
**Step 21 - Node 1 complete**

- `00:14:14.318` Node 1 is wired. Compare your board with this diagram, wire by wire.
- `00:14:21.372` With the meter in continuity mode, check each wire end to end, and check that transmit and receive are not swapped.
- `00:14:29.965` The terminator and bus wires come later, in the bus scene.

## Scene 4: Assemble Node 2 - Battery ECU

**Step 22 - Place ESP2 and TRX2**

- `00:14:36.464` Node two repeats Node one exactly: the same four pins and the same colours.
- `00:14:42.922` Node 2 goes on breadboard A. Seat ESP2 across the centre trench in columns 32 to 46.
- `00:14:51.761` Gate G3: every pin must still have at least one free hole beside it on both sides. If not, do not force it.
- `00:15:01.699` Place TRX2 in the lower half, around columns 49 to 55.
- `00:15:08.513` Everything stays unplugged.
- `00:15:11.552` What is different: Node two is in the middle of the bus, so it has no terminator, and its 3V3 must never touch Node one's 3V3.
**Step 23 - Node 2 pin plan**

- `00:15:23.780` Node 2 uses only four ESP32 pins, all on the 3V3-side header.
- `00:15:31.078` Three volt three, ground, RX2 which is GPIO sixteen, and TX2 which is GPIO seventeen.
- `00:15:41.052` Every other pin stays empty.
**Step 24 - N2-01**

- `00:15:45.531` Connection N2-01.
- `00:15:49.185` Take a red jumper.
- `00:15:51.664` One end goes to ESP2 pin 3V3: the first pin from the USB end on the 3V3 side header.
- `00:16:00.453` The other end goes to the TRX2 pin printed 3V3.
- `00:16:05.746` Signal: 3V3_N2.
- `00:16:10.301` Status: provisional. Make it only after gates G1, G2 and G4 have passed and you have recorded the results.
- `00:16:20.513` Check: Continuity ESP2 3V3 to TRX2 3V3. NO continuity to Node 1 3V3.
**Step 25 - N2-02**

- `00:16:32.587` Connection N2-02.
- `00:16:36.216` Take a black jumper.
- `00:16:38.800` One end goes to ESP2 pin GND: the second pin from the USB end on the 3V3 side header.
- `00:16:47.144` The other end goes to the TRX2 pin printed GND.
- `00:16:51.987` Signal: GND.
- `00:16:54.932` Status: provisional. Make it only after gates G2 and G4 have passed and you have recorded the results.
- `00:17:04.255` Check: Continuity ESP2 GND to TRX2 GND.
**Step 26 - N2-03**

- `00:17:11.723` Connection N2-03.
- `00:17:15.438` Take a white jumper.
- `00:17:17.942` One end goes to ESP2 pin TX2, GPIO 17: the seventh pin from the USB end on the 3V3 side header.
- `00:17:28.900` The other end goes to the TRX2 pin printed CTX.
- `00:17:34.269` Signal: CAN_TX_N2 (GPIO17).
- `00:17:40.093` Status: provisional. Make it only after gates G1, G2 and G4 have passed and you have recorded the results.
- `00:17:50.306` Check: Continuity TX2 pin to CTX pin; NOT to CRX.
**Step 27 - N2-04**

- `00:17:59.044` Connection N2-04.
- `00:18:02.759` Take a brown jumper.
- `00:18:05.343` One end goes to ESP2 pin RX2, GPIO 16: the sixth pin from the USB end on the 3V3 side header.
- `00:18:16.001` The other end goes to the TRX2 pin printed CRX.
- `00:18:21.300` Signal: CAN_RX_N2 (GPIO16).
- `00:18:26.874` Status: provisional. Make it only after gates G1, G2 and G4 have passed and you have recorded the results.
- `00:18:37.087` Check: Continuity RX2 pin to CRX pin; NOT to CTX.
**Step 28 - Node 2 complete**

- `00:18:45.706` Node 2 is wired. Compare your board with this diagram, wire by wire.
- `00:18:52.779` With the meter in continuity mode, check each wire end to end, and check that transmit and receive are not swapped.
- `00:19:01.373` The terminator and bus wires come later, in the bus scene.

## Scene 5: Assemble Node 3 - CANScope monitor

**Step 29 - Place Node 3**

- `00:19:07.871` Node three has breadboard B to itself. Seat ESP3 in columns one to fifteen.
- `00:19:15.725` Put TRX3 and the OLED in the lower half, the buzzer driver, LEDs and buttons in the upper half.
- `00:19:23.968` Gate G14: check each rail with the meter from end to end. Some breadboards split their rails in the middle.
- `00:19:32.801` On breadboard B, the bottom plus rail is 3V3 for Node three only. Both minus rails are ground.
**Step 30 - N3-01**

- `00:19:43.190` Connection N3-01.
- `00:19:46.914` Take a red jumper.
- `00:19:49.393` One end goes to ESP3 pin 3V3: the first pin from the USB end on the 3V3 side header.
- `00:19:58.196` The other end goes to the bottom plus rail of breadboard B, which is 3V3 for Node 3.
- `00:20:05.375` Signal: 3V3_N3.
- `00:20:09.999` Status: provisional. Make it only after gates G2 and G14 have passed and you have recorded the results.
- `00:20:19.577` Check: Continuity 3V3 pin to bottom + rail.
**Step 31 - N3-02**

- `00:20:26.200` Connection N3-02.
- `00:20:29.900` Take a black jumper.
- `00:20:32.484` One end goes to ESP3 pin GND: the second pin from the USB end on the 3V3 side header.
- `00:20:40.847` The other end goes to the bottom minus rail of breadboard B, which is ground.
- `00:20:46.836` Signal: GND.
- `00:20:49.780` Status: provisional. Make it only after gates G2 and G14 have passed and you have recorded the results.
- `00:20:59.358` Check: Continuity GND pin (3V3 side) to bottom - rail.
**Step 32 - N3-03**

- `00:21:08.107` Connection N3-03.
- `00:21:11.891` Take a black jumper.
- `00:21:14.475` One end goes to the bottom minus rail of breadboard B, which is ground.
- `00:21:20.284` The other end goes to the top minus rail of breadboard B, which is ground.
- `00:21:26.273` Signal: GND (rail link, far right end of board B).
- `00:21:32.306` Status: provisional. Make it only after gate G14 have passed and you have recorded the results.
- `00:21:41.119` Check: Continuity bottom - rail to top - rail: near 0 Ohm. Never link a - rail to a + rail.
**Step 33 - N3-04**

- `00:21:53.088` Connection N3-04.
- `00:21:56.867` Take a red jumper.
- `00:21:59.346` One end goes to the bottom plus rail of breadboard B, which is 3V3 for Node 3.
- `00:22:06.335` The other end goes to the TRX3 pin printed 3V3.
- `00:22:11.633` Signal: 3V3_N3.
- `00:22:16.257` Status: provisional. Make it only after gate G4 have passed and you have recorded the results.
- `00:22:24.810` Check: Continuity + rail to TRX3 3V3.
**Step 34 - N3-05**

- `00:22:31.944` Connection N3-05.
- `00:22:35.768` Take a black jumper.
- `00:22:38.353` One end goes to the bottom minus rail of breadboard B, which is ground.
- `00:22:44.161` The other end goes to the TRX3 pin printed GND.
- `00:22:49.015` Signal: GND.
- `00:22:51.959` Status: provisional. Make it only after gate G4 have passed and you have recorded the results.
- `00:23:00.512` Check: Continuity - rail to TRX3 GND.
**Step 35 - N3-06**

- `00:23:07.386` Connection N3-06.
- `00:23:11.311` Take a white jumper.
- `00:23:13.815` One end goes to ESP3 pin TX2, GPIO 17: the seventh pin from the USB end on the 3V3 side header.
- `00:23:24.788` The other end goes to the TRX3 pin printed CTX.
- `00:23:30.162` Signal: CAN_TX_N3 (GPIO17).
- `00:23:36.061` Status: provisional. Make it only after gates G1, G2 and G4 have passed and you have recorded the results.
- `00:23:46.274` Check: Continuity TX2 to CTX; NOT to CRX.
**Step 36 - N3-07**

- `00:23:54.532` Connection N3-07.
- `00:23:58.372` Take a brown jumper.
- `00:24:00.956` One end goes to ESP3 pin RX2, GPIO 16: the sixth pin from the USB end on the 3V3 side header.
- `00:24:11.624` The other end goes to the TRX3 pin printed CRX.
- `00:24:16.923` Signal: CAN_RX_N3 (GPIO16).
- `00:24:22.572` Status: provisional. Make it only after gates G1, G2 and G4 have passed and you have recorded the results.
- `00:24:32.785` Check: Continuity RX2 to CRX; NOT to CTX.
**Step 37 - OLED**

- `00:24:40.944` Now the OLED. Its pins are wired by printed name, not by position.
- `00:24:47.887` SDA goes to GPIO twenty-one and SCL to GPIO twenty-two. These are the standard I2C pins in the Arduino ESP32 core.
- `00:25:00.500` That is also why Node three does not use twenty-one and twenty-two for CAN.
**Step 38 - N3-10**

- `00:25:07.804` Connection N3-10.
- `00:25:11.508` Take a red jumper.
- `00:25:13.987` One end goes to the bottom plus rail of breadboard B, which is 3V3 for Node 3.
- `00:25:20.976` The other end goes to the OLED pin printed VCC.
- `00:25:25.409` Signal: 3V3_N3.
- `00:25:30.033` Status: provisional. Make it only after gate G7 have passed and you have recorded the results.
- `00:25:38.672` Check: Continuity + rail to the pin PRINTED VCC/VDD (not by position).
**Step 39 - N3-11**

- `00:25:47.920` Connection N3-11.
- `00:25:51.499` Take a black jumper.
- `00:25:54.083` One end goes to the bottom minus rail of breadboard B, which is ground.
- `00:25:59.892` The other end goes to the OLED pin printed GND.
- `00:26:04.071` Signal: GND.
- `00:26:07.015` Status: provisional. Make it only after gate G7 have passed and you have recorded the results.
- `00:26:15.653` Check: Continuity - rail to the pin PRINTED GND.
**Step 40 - N3-12**

- `00:26:22.307` Connection N3-12.
- `00:26:25.861` Take a blue jumper.
- `00:26:28.346` One end goes to ESP3 pin D21, GPIO 21: the eleventh pin from the USB end on the 3V3 side header.
- `00:26:39.304` The other end goes to the OLED pin printed SDA.
- `00:26:43.668` Signal: I2C_SDA (GPIO21).
- `00:26:49.421` Status: provisional. Make it only after gates G2 and G7 have passed and you have recorded the results.
- `00:26:58.819` Check: Continuity D21 to SDA; NOT to SCL.
**Step 41 - N3-13**

- `00:27:06.673` Connection N3-13.
- `00:27:10.297` Take a purple jumper.
- `00:27:12.932` One end goes to ESP3 pin D22, GPIO 22: the fourteenth pin from the USB end on the 3V3 side header.
- `00:27:24.004` The other end goes to the OLED pin printed SCL.
- `00:27:28.488` Signal: I2C_SCL (GPIO22).
- `00:27:34.357` Status: provisional. Make it only after gates G2 and G7 have passed and you have recorded the results.
- `00:27:43.755` Check: Continuity D22 to SCL; NOT to SDA.
**Step 42 - LED circuits**

- `00:27:51.654` Each LED gets its own 220 ohm resistor. Never share one resistor between LEDs.
- `00:27:59.897` The GPIO drives the resistor, the resistor feeds the anode, and the cathode goes to ground.
- `00:28:07.736` The current is about six milliamps, well within the pin's limit.
**Step 43 - N3-14**

- `00:28:14.374` Connection N3-14.
- `00:28:18.013` Take a grey jumper.
- `00:28:20.568` One end goes to ESP3 pin D25, GPIO 25: the eighth pin from the USB end on the VIN side header.
- `00:28:31.151` The other end goes to R_G, the 220 Ohm (green LED), end 1.
- `00:28:38.580` Signal: LED_GREEN (GPIO25).
- `00:28:43.918` Status: provisional. Make it only after gates G2 and G13 have passed and you have recorded the results.
- `00:28:53.446` Check: Continuity D25 to one end of the green 220 Ohm.
**Step 44 - N3-15**

- `00:29:01.620` Connection N3-15.
- `00:29:05.289` This is a component lead, not a jumper wire.
- `00:29:09.713` One end goes to R_G, the 220 Ohm (green LED), end 2.
- `00:29:16.902` The other end goes to LED_G anode.
- `00:29:20.371` Signal: LED_GREEN via 220.
- `00:29:25.035` Status: provisional. Make it only after gate G9 have passed and you have recorded the results.
- `00:29:33.578` Check: Resistor and anode share one 5-hole strip; nothing else in it.
**Step 45 - N3-16**

- `00:29:41.491` Connection N3-16.
- `00:29:45.276` This is a component lead, not a jumper wire.
- `00:29:49.699` One end goes to LED_G cathode.
- `00:29:53.158` The other end goes to the top minus rail of breadboard B, which is ground.
- `00:29:59.147` Signal: GND.
- `00:30:02.091` Status: provisional. Make it only after gates G9 and G14 have passed and you have recorded the results.
- `00:30:11.684` Check: Cathode (short leg, flat side) to top GND rail.
**Step 46 - N3-17**

- `00:30:20.158` Connection N3-17.
- `00:30:23.852` Take a grey jumper.
- `00:30:26.406` One end goes to ESP3 pin D26, GPIO 26: the seventh pin from the USB end on the VIN side header.
- `00:30:37.144` The other end goes to R_Y, the 220 Ohm (yellow LED), end 1.
- `00:30:44.578` Signal: LED_YELLOW (GPIO26).
- `00:30:49.992` Status: provisional. Make it only after gates G2 and G13 have passed and you have recorded the results.
- `00:30:59.520` Check: Continuity D26 to one end of the yellow 220 Ohm.
**Step 47 - N3-18**

- `00:31:07.688` Connection N3-18.
- `00:31:11.223` This is a component lead, not a jumper wire.
- `00:31:15.646` One end goes to R_Y, the 220 Ohm (yellow LED), end 2.
- `00:31:22.835` The other end goes to LED_Y anode.
- `00:31:26.289` Signal: LED_YELLOW via 220.
- `00:31:30.973` Status: provisional. Make it only after gate G9 have passed and you have recorded the results.
- `00:31:39.516` Check: Resistor and anode share one strip.
**Step 48 - N3-19**

- `00:31:45.385` Connection N3-19.
- `00:31:49.009` This is a component lead, not a jumper wire.
- `00:31:53.433` One end goes to LED_Y cathode.
- `00:31:56.832` The other end goes to the top minus rail of breadboard B, which is ground.
- `00:32:02.821` Signal: GND.
- `00:32:05.765` Status: provisional. Make it only after gates G9 and G14 have passed and you have recorded the results.
- `00:32:15.358` Check: Cathode to top GND rail.
**Step 49 - N3-20**

- `00:32:20.867` Connection N3-20.
- `00:32:24.551` Take a grey jumper.
- `00:32:27.105` One end goes to ESP3 pin D27, GPIO 27: the sixth pin from the USB end on the VIN side header.
- `00:32:37.793` The other end goes to R_R, the 220 Ohm (red LED), end 1.
- `00:32:45.137` Signal: LED_RED (GPIO27).
- `00:32:50.396` Status: provisional. Make it only after gates G2 and G13 have passed and you have recorded the results.
- `00:32:59.924` Check: Continuity D27 to one end of the red 220 Ohm.
**Step 50 - N3-21**

- `00:33:08.027` Connection N3-21.
- `00:33:11.577` This is a component lead, not a jumper wire.
- `00:33:16.000` One end goes to R_R, the 220 Ohm (red LED), end 2.
- `00:33:23.119` The other end goes to LED_R anode.
- `00:33:26.513` Signal: LED_RED via 220.
- `00:33:31.077` Status: provisional. Make it only after gate G9 have passed and you have recorded the results.
- `00:33:39.620` Check: Resistor and anode share one strip.
**Step 51 - N3-22**

- `00:33:45.489` Connection N3-22.
- `00:33:49.003` This is a component lead, not a jumper wire.
- `00:33:53.427` One end goes to LED_R cathode.
- `00:33:56.821` The other end goes to the top minus rail of breadboard B, which is ground.
- `00:34:02.810` Signal: GND.
- `00:34:05.754` Status: provisional. Make it only after gates G9 and G14 have passed and you have recorded the results.
- `00:34:15.347` Check: Cathode to top GND rail.
**Step 52 - Buttons**

- `00:34:20.856` Place each button across the centre trench.
- `00:34:24.850` The GPIO goes to leg L1 and ground goes to the diagonally opposite leg L3.
- `00:34:31.513` Firmware will use the internal pull-up, so the pin reads low when pressed. That firmware does not exist yet.
**Step 53 - N3-23**

- `00:34:42.132` Connection N3-23.
- `00:34:45.741` Take a white jumper.
- `00:34:48.245` One end goes to ESP3 pin D32, GPIO 32: the tenth pin from the USB end on the VIN side header.
- `00:34:58.463` The other end goes to BTN_A leg L1.
- `00:35:02.298` Signal: BUTTON_A (GPIO32, internal pull-up, active LOW).
- `00:35:09.901` Status: provisional. Make it only after gates G2 and G8 have passed and you have recorded the results.
- `00:35:19.139` Check: Continuity D32 to leg L1 of button A.
**Step 54 - N3-24**

- `00:35:25.913` Connection N3-24.
- `00:35:29.522` Take a black jumper.
- `00:35:32.107` One end goes to BTN_A leg L3.
- `00:35:35.776` The other end goes to the top minus rail of breadboard B, which is ground.
- `00:35:41.764` Signal: GND.
- `00:35:44.709` Status: provisional. Make it only after gate G8 have passed and you have recorded the results.
- `00:35:53.172` Check: L3 is DIAGONAL to L1. D32-to-GND: open released, ~0 Ohm pressed.
**Step 55 - N3-25**

- `00:36:04.275` Connection N3-25.
- `00:36:07.924` Take a white jumper.
- `00:36:10.429` One end goes to ESP3 pin D33, GPIO 33: the ninth pin from the USB end on the VIN side header.
- `00:36:20.817` The other end goes to BTN_B leg L1.
- `00:36:24.651` Signal: BUTTON_B (GPIO33, internal pull-up, active LOW).
- `00:36:32.410` Status: provisional. Make it only after gates G2 and G8 have passed and you have recorded the results.
- `00:36:41.648` Check: Continuity D33 to leg L1 of button B.
**Step 56 - N3-26**

- `00:36:48.501` Connection N3-26.
- `00:36:52.251` Take a black jumper.
- `00:36:54.835` One end goes to BTN_B leg L3.
- `00:36:58.509` The other end goes to the top minus rail of breadboard B, which is ground.
- `00:37:04.498` Signal: GND.
- `00:37:07.442` Status: provisional. Make it only after gate G8 have passed and you have recorded the results.
- `00:37:15.905` Check: D33-to-GND: open released, ~0 Ohm pressed.
**Step 57 - Buzzer driver design**

- `00:37:24.054` The buzzer needs five volts, so a GPIO cannot drive it directly. A small NPN transistor switches its low side.
- `00:37:34.422` GPIO thirteen drives the base through one kilo-ohm, about two point six milliamps, enough to switch thirty milliamps.
- `00:37:44.065` A ten kilo-ohm resistor from base to ground keeps the buzzer quiet while the ESP32 boots.
- `00:37:51.523` The buzzer's plus side takes five volts from Node three's own VIN pin, later. Its minus side goes to the collector, and the emitter goes to ground.
- `00:38:03.041` The transistor's leg order is still blocked, so the transistor connections are not made now.
**Step 58 - N3-27**

- `00:38:11.374` Connection N3-27.
- `00:38:15.053` Take a grey jumper.
- `00:38:17.608` One end goes to ESP3 pin D13, GPIO 13: the third pin from the USB end on the VIN side header.
- `00:38:27.721` The other end goes to R_B, the 1 kOhm base resistor, end 1.
- `00:38:34.045` Signal: BUZZER_DRIVE (GPIO13).
- `00:38:39.364` Status: provisional. Make it only after gates G2 and G13 have passed and you have recorded the results.
- `00:38:48.891` Check: Continuity D13 (3rd pin from USB, VIN side) to one end of the 1 kOhm. The 4th pin, D12, is a strapping pin: make sure it stays EMPTY. D13 has NO path to the buzzer except through Q1.
- `00:39:09.293` Double check: pin D13 is the third pin from USB. The fourth pin, D12, is a strapping pin and must stay empty.
**Step 59 - N3-28**

- `00:39:21.421` Connection N3-28.
- `00:39:24.931` This is a component lead, not a jumper wire.
- `00:39:29.355` One end goes to R_B, the 1 kOhm base resistor, end 2.
- `00:39:35.438` The other end goes to Q1 base.
- `00:39:38.932` Signal: Q1 base via 1 kOhm.
- `00:39:43.941` Status: BLOCKED. Do not make this connection. Gate G10 must be resolved and the ledger updated first.
- `00:39:53.944` Check: Blocked until Q1 part number and its E/B/C order are recorded.
**Step 60 - N3-29**

- `00:40:02.543` Connection N3-29.
- `00:40:06.162` This is a component lead, not a jumper wire.
- `00:40:10.586` One end goes to R_PD, the 10 kOhm base pull-down, end 1.
- `00:40:17.110` The other end goes to Q1 base.
- `00:40:20.604` Signal: base pull-down (boot-quiet).
- `00:40:25.163` Status: BLOCKED. Do not make this connection. Gate G10 must be resolved and the ledger updated first.
- `00:40:35.166` Check: Blocked until Q1 pinout is recorded.
**Step 61 - N3-30**

- `00:40:41.260` Connection N3-30.
- `00:40:45.009` This is a component lead, not a jumper wire.
- `00:40:49.433` One end goes to R_PD, the 10 kOhm base pull-down, end 2.
- `00:40:55.907` The other end goes to the top minus rail of breadboard B, which is ground.
- `00:41:01.895` Signal: GND.
- `00:41:04.839` Status: BLOCKED. Do not make this connection. Gate G10 must be resolved and the ledger updated first.
- `00:41:14.843` Check: Blocked until Q1 pinout is recorded.
**Step 62 - N3-31**

- `00:41:20.937` Connection N3-31.
- `00:41:24.561` Take a black jumper.
- `00:41:27.145` One end goes to Q1 emitter.
- `00:41:30.449` The other end goes to the top minus rail of breadboard B, which is ground.
- `00:41:36.438` Signal: GND (emitter).
- `00:41:40.347` Status: BLOCKED. Do not make this connection. Gate G10 must be resolved and the ledger updated first.
- `00:41:50.350` Check: Blocked until Q1 pinout is recorded.
**Step 63 - N3-32**

- `00:41:56.444` Connection N3-32.
- `00:42:00.033` This is a component lead, not a jumper wire.
- `00:42:04.457` One end goes to Q1 collector.
- `00:42:07.886` The other end goes to BZ1 minus.
- `00:42:11.640` Signal: BUZZER_LOW (collector).
- `00:42:15.769` Status: BLOCKED. Do not make this connection. Gate G10 and G11 must be resolved and the ledger updated first.
- `00:42:26.607` Check: Blocked until Q1 pinout and buzzer polarity are recorded.
**Step 64 - N3-33**

- `00:42:33.891` Connection N3-33.
- `00:42:37.565` This is a component lead, not a jumper wire.
- `00:42:41.989` One end goes to D1 anode.
- `00:42:45.183` The other end goes to BZ1 minus.
- `00:42:48.937` Signal: flyback diode anode.
- `00:42:52.781` Status: provisional. Make it only after gate G11 have passed and you have recorded the results.
- `00:43:01.454` Check: Only if G11 says electromagnetic. Band (cathode) goes to the + side.
**Step 65 - N3-34**

- `00:43:11.858` Connection N3-34.
- `00:43:15.532` This is a component lead, not a jumper wire.
- `00:43:19.956` One end goes to D1 cathode.
- `00:43:23.350` The other end goes to BZ1 plus.
- `00:43:27.099` Signal: flyback diode cathode.
- `00:43:31.133` Status: provisional. Make it only after gate G11 have passed and you have recorded the results.
- `00:43:39.806` Check: Band toward buzzer +.
**Step 66 - Node 3 complete (buzzer supply deferred)**

- `00:43:45.065` Node three is wired, except for the blocked transistor connections and the buzzer supply.
- `00:43:51.699` The buzzer supply wire, N3-35, is installed only after the first power-up check, and only once the transistor is resolved.

## Scene 6: Build the CAN bus

**Step 67 - Bus topology**

- `00:44:04.407` The bus is one straight line: end A at Node one, through Node two, to end B at Node three.
- `00:44:12.465` A star or Y-shaped branch makes reflections that corrupt bits, so every node sits directly on the line with a short tap.
- `00:44:21.603` The two terminators absorb the signal at the ends. Twist each CAN high and CAN low pair together, and run the ground wire beside it.
**Step 68 - Terminator decision**

- `00:44:33.216` Use your gate G6 readings now.
- `00:44:36.695` If no module has an onboard terminator, fit RT1 at Node one and RT2 at Node three, exactly as shown.
- `00:44:46.268` If the Node one or Node three module already has one, leave out that external resistor.
- `00:44:53.152` If the Node two module has one, stop until it is removed.
**Step 69 - N1-05**

- `00:44:59.976` Connection N1-05.
- `00:45:03.750` This is a component lead, not a jumper wire.
- `00:45:08.174` One end goes to RT1, the 120 Ohm terminator, bus end A, end 1.
- `00:45:16.137` The other end goes to the TRX1 pin printed CANH.
- `00:45:20.976` Signal: CANH (end A terminator).
- `00:45:25.470` Status: provisional. Make it only after gates G6 and G13 have passed and you have recorded the results.
- `00:45:35.083` Check: Fit only if G6 found no onboard terminator on TRX1.
**Step 70 - N1-06**

- `00:45:43.146` Connection N1-06.
- `00:45:47.016` This is a component lead, not a jumper wire.
- `00:45:51.440` One end goes to RT1, the 120 Ohm terminator, bus end A, end 2.
- `00:45:59.368` The other end goes to the TRX1 pin printed CANL.
- `00:46:04.222` Signal: CANL (end A terminator).
- `00:46:08.731` Status: provisional. Make it only after gates G6 and G13 have passed and you have recorded the results.
- `00:46:18.344` Check: RT1 measured 114-126 Ohm before fitting.
**Step 71 - B-01**

- `00:46:27.207` Connection B-01.
- `00:46:30.081` Take a yellow jumper.
- `00:46:32.690` One end goes to the TRX1 pin printed CANH.
- `00:46:37.344` The other end goes to the TRX2 pin printed CANH.
- `00:46:42.188` Signal: CANH trunk, segment 1.
- `00:46:46.887` Status: provisional. Make it only after gate G4 have passed and you have recorded the results.
- `00:46:55.440` Check: Continuity TRX1 CANH to TRX2 CANH; no continuity CANH to CANL other than through terminators.
**Step 72 - B-02**

- `00:47:07.113` Connection B-02.
- `00:47:09.962` Take a green jumper.
- `00:47:12.512` One end goes to the TRX1 pin printed CANL.
- `00:47:17.181` The other end goes to the TRX2 pin printed CANL.
- `00:47:22.040` Signal: CANL trunk, segment 1.
- `00:47:26.754` Status: provisional. Make it only after gate G4 have passed and you have recorded the results.
- `00:47:35.307` Check: Twist with B-01. Continuity TRX1 CANL to TRX2 CANL.
**Step 73 - B-03**

- `00:47:45.400` Connection B-03.
- `00:47:48.335` Take a black jumper.
- `00:47:50.919` One end goes to the TRX1 pin printed GND.
- `00:47:55.583` The other end goes to the TRX2 pin printed GND.
- `00:48:00.427` Signal: GND reference, segment 1.
- `00:48:05.216` Status: provisional. Make it only after gate G4 have passed and you have recorded the results.
- `00:48:13.769` Check: Continuity Node 1 GND to Node 2 GND.
**Step 74 - B-04**

- `00:48:20.373` Connection B-04.
- `00:48:23.307` Take a yellow jumper.
- `00:48:25.916` One end goes to the TRX2 pin printed CANH.
- `00:48:30.575` The other end goes to the TRX3 pin printed CANH.
- `00:48:35.419` Signal: CANH trunk, segment 2 (board A to B).
- `00:48:41.417` Status: provisional. Make it only after gate G4 have passed and you have recorded the results.
- `00:48:49.970` Check: Continuity TRX2 CANH to TRX3 CANH.
- `00:48:56.159` This wire crosses from breadboard A to breadboard B. Keep it short and twisted with its partner.
**Step 75 - B-05**

- `00:49:04.238` Connection B-05.
- `00:49:07.212` Take a green jumper.
- `00:49:09.761` One end goes to the TRX2 pin printed CANL.
- `00:49:14.435` The other end goes to the TRX3 pin printed CANL.
- `00:49:19.294` Signal: CANL trunk, segment 2 (board A to B).
- `00:49:25.298` Status: provisional. Make it only after gate G4 have passed and you have recorded the results.
- `00:49:33.851` Check: Twist with B-04. Continuity TRX2 CANL to TRX3 CANL.
- `00:49:42.594` This wire crosses from breadboard A to breadboard B. Keep it short and twisted with its partner.
**Step 76 - B-06**

- `00:49:50.673` Connection B-06.
- `00:49:53.747` Take a black jumper.
- `00:49:56.331` One end goes to the TRX2 pin printed GND.
- `00:50:00.990` The other end goes to the bottom minus rail of breadboard B, which is ground.
- `00:50:06.979` Signal: GND reference, segment 2.
- `00:50:11.743` Status: provisional. Make it only after gates G4 and G14 have passed and you have recorded the results.
- `00:50:21.376` Check: Continuity Node 2 GND to Node 3 GND rail.
**Step 77 - N3-08**

- `00:50:28.299` Connection N3-08.
- `00:50:31.979` This is a component lead, not a jumper wire.
- `00:50:36.402` One end goes to RT2, the 120 Ohm terminator, bus end B, end 1.
- `00:50:44.486` The other end goes to the TRX3 pin printed CANH.
- `00:50:49.330` Signal: CANH (end B terminator).
- `00:50:53.878` Status: provisional. Make it only after gates G6 and G13 have passed and you have recorded the results.
- `00:51:03.491` Check: Fit only if G6 found no onboard terminator on TRX3.
**Step 78 - N3-09**

- `00:51:11.605` Connection N3-09.
- `00:51:15.399` This is a component lead, not a jumper wire.
- `00:51:19.823` One end goes to RT2, the 120 Ohm terminator, bus end B, end 2.
- `00:51:27.871` The other end goes to the TRX3 pin printed CANL.
- `00:51:32.730` Signal: CANL (end B terminator).
- `00:51:37.294` Status: provisional. Make it only after gates G6 and G13 have passed and you have recorded the results.
- `00:51:46.907` Check: RT2 measured 114-126 Ohm before fitting.
**Step 79 - Bus complete**

- `00:51:55.840` The bus is complete. There are two terminators, one at each physical end, and none at Node two.
- `00:52:04.294` CAN high only ever meets CAN high, and CAN low only ever meets CAN low.

## Scene 7: Inspect before powering

**Step 80 - Ledger walk-through**

- `00:52:11.612` With everything unplugged, check every wire against the ledger checklist, both ends, one row at a time.
- `00:52:20.066` Tick a row only after you have looked at it and tested it with the meter.
- `00:52:24.955` Every blocked row must be empty on the breadboard.
**Step 81 - Rail short check**

- `00:52:30.384` Check the supplies for shorts, with all power removed.
- `00:52:35.343` Measure from three volt three to ground on each node, and from Node three's VIN to ground.
- `00:52:42.116` The reading may start low and climb as capacitors charge. That is normal.
- `00:52:48.630` A steady reading near zero ohms is a short. Find it before any cable is plugged in.
**Step 82 - CAN continuity and polarity**

- `00:52:57.203` Check CAN high from Node one to Node two to Node three. It should read almost zero ohms.
- `00:53:04.752` Do the same for CAN low.
- `00:53:07.621` Then check that neither line connects to ground, a supply, or any ESP32 pin.
**Step 83 - Termination resistance**

- `00:53:16.600` Now measure CAN high to CAN low anywhere on the bus.
- `00:53:20.879` Two 120 ohm resistors in parallel give 120 times 120 divided by 240, which is 60 ohms.
- `00:53:32.101` About 120 means one terminator is missing. About 40 means there is a third, probably an onboard one.
- `00:53:41.729` Record the value. Do not add resistors to fix a reading until you know why it is wrong.
**Step 84 - Buzzer and 5 V checks**

- `00:53:50.442` Last checks. GPIO thirteen must connect only to the base resistor, never to the buzzer.
- `00:53:58.806` The buzzer's plus leg has no wire yet.
- `00:54:02.655` VIN must have no wire to any three volt three point.
- `00:54:07.319` And the three volt three pins of Node one and Node two must not be connected to each other.

## Scene 8: First power-up

**Step 85 - Power-up rules**

- `00:54:14.917` Power up one node at a time. The bus stays isolated from any vehicle or network.
- `00:54:22.076` The other two nodes stay unplugged. TI's datasheet says an unpowered SN65HVD230 does not disturb the bus, so the bus wires can stay in place.
- `00:54:35.513` Watch and feel for heat, smell or repeated resets. If you notice any, unplug at once.
- `00:54:43.862` Never change a wire while a cable is plugged in.
**Step 86 - Node 1 alone**

- `00:54:49.456` Plug in Node 1 only, and open a serial monitor at 115200 baud.
- `00:54:58.604` The banner lines start with a hash sign. Look for CAN init OK, controller running.
- `00:55:06.057` Measure the transceiver supply. It must be between three point zero and three point six volts.
- `00:55:13.940` Then unplug it.
**Step 87 - Node 2 alone**

- `00:55:17.690` Plug in Node 2 only, and open a serial monitor at 115200 baud.
- `00:55:26.838` The banner lines start with a hash sign. Look for CAN init OK, controller running.
- `00:55:34.291` Measure the transceiver supply. It must be between three point zero and three point six volts.
- `00:55:42.174` Node two alone will report transmit errors, because no other node is powered to acknowledge its frames. That is expected at this stage.
- `00:55:52.887` Then unplug it.
**Step 88 - Node 3 alone**

- `00:55:56.637` Plug in Node 3 only, and open a serial monitor at 115200 baud.
- `00:56:05.780` The banner lines start with a hash sign. Look for CAN init OK, controller running.
- `00:56:13.233` Measure the transceiver supply. It must be between three point zero and three point six volts.
- `00:56:21.116` On Node three, also measure VIN to ground. This is gate G12. It must be between four point four and five point two five volts.
- `00:56:33.004` Then unplug it.
**Step 89 - N3-35 (deferred)**

- `00:56:36.754` Connection N3-35.
- `00:56:40.468` Take a orange jumper.
- `00:56:43.132` One end goes to ESP3 pin VIN: the first pin from the USB end on the VIN side header.
- `00:56:50.995` The other end goes to BZ1 plus.
- `00:56:54.745` Signal: 5V_USB_N3 (buzzer supply).
- `00:57:00.279` Status: provisional. Make it only after gates G11 and G12 have passed and you have recorded the results.
- `00:57:09.816` Check: Install LAST, with power off, after G12. No continuity from this wire to any 3V3 pin or rail.
- `00:57:20.930` Today this wire stays OUT: the buzzer driver is blocked until the transistor is identified. Install it later only with all power off, after G10, G11 and G12 pass.

## Scene 9: Three-node bring-up

**Step 90 - Compile is not communication**

- `00:57:36.697` A successful compile only proves the code built.
- `00:57:41.046` When Node two prints sent CAN ID, the frame was queued. That alone does not prove it reached the bus.
- `00:57:49.479` The evidence is another node printing a frame line with that CAN ID, while the error counters stay low and no bus-off alert appears.
**Step 91 - Two-node test**

- `00:57:59.977` Plug in Node one, then Node two. Node three stays unplugged.
- `00:58:06.486` On Node one's serial monitor, look for lines of JSON with type frame.
- `00:58:12.885` You should see CAN IDs 0x201, 0x202 and 0x203 about once a second, and 0x210 twice a second.
- `00:58:23.813` Node one acknowledges the frames, so Node two's transmit errors should stop.
- `00:58:30.376` Write down exactly what you see. If nothing arrives, unplug everything and go to the troubleshooting table.
**Step 92 - Three-node test**

- `00:58:40.390` Now plug in Node three. Nothing is rewired, and both terminators stay at the two ends.
- `00:58:48.398` Node three's monitor firmware is listen-only. It should print the same frame IDs.
- `00:58:55.621` The OLED, LEDs and buttons will do nothing yet, because no firmware drives them. That is expected, not a fault.

## Scene 10: Final inspection and handover

**Step 93 - All nodes**

- `00:59:07.554` Here is the finished build. Compare all three nodes and the bus with the manual one last time.
- `00:59:15.068` Photograph each node and the whole bus, and keep the photos with the sign-off sheet.
**Step 94 - Tested vs untested**

- `00:59:22.906` To be clear about what has been tested.
- `00:59:26.311` The documents, the pin ledger and the firmware pin settings were checked against each other. No hardware was inspected, measured or powered by Claude.
- `00:59:37.408` Each gate, the 60 ohm reading and the frame capture become verified only when you record them.
- `00:59:44.577` The transistor connections and the buzzer supply are still blocked, and the peripheral firmware still has to be written.
- `00:59:52.545` Thank you for building carefully.
