Naveen-kumar14/CanScope/video/storyboard.md

# CANScope physical build video: storyboard

One row per step. Every diagram is a schematic illustration generated from the pin ledger; no photographs of the builder's hardware were available. Wire steps show the ledger row in the right panel (FROM, TO, signal, colour, status, gates, check).

| Step | Time | Scene | Title | Visual | Panel | Power state |
|---|---|---|---|---|---|---|
| 1 | 00:00:00.000 - 00:00:28.344 | 1 | Title | text card: CANScope: building the three-node CAN bench | - | ALL POWER OFF - every USB cable unplugged |
| 2 | 00:00:28.344 - 00:01:08.911 | 1 | Architecture | bus diagram | Three nodes, one bus | ALL POWER OFF - every USB cable unplugged |
| 3 | 00:01:08.911 - 00:01:58.211 | 1 | What is and is not verified | text card: Honest status before you start | - | ALL POWER OFF - every USB cable unplugged |
| 4 | 00:01:58.211 - 00:02:57.714 | 1 | Inventory | text card: Inventory and tools | - | ALL POWER OFF - every USB cable unplugged |
| 5 | 00:02:57.714 - 00:03:46.463 | 1 | Safety | text card: Safety rules - read before touching a wire | - | ALL POWER OFF - every USB cable unplugged |
| 6 | 00:03:46.463 - 00:04:22.811 | 1 | Status legend and gates | text card: How to read every wiring step | - | ALL POWER OFF - every USB cable unplugged |
| 7 | 00:04:22.811 - 00:05:20.469 | 1 | Flash before wiring | text card: Before any wire: flash each BARE board | - | One bare board on USB at a time, nothing else connected |
| 8 | 00:05:20.469 - 00:06:17.568 | 2 | ESP32 pin locator | sheet `01_esp32_pin_locator` | gates G1, G2 | ALL POWER OFF - every USB cable unplugged |
| 9 | 00:06:17.568 - 00:07:28.546 | 2 | Transceiver identity | sheet `02_transceiver_identification` | gates G4, G5 | ALL POWER OFF - every USB cable unplugged |
| 10 | 00:07:28.546 - 00:08:13.121 | 2 | Onboard termination | sheet `02_transceiver_identification` | gates G6 | ALL POWER OFF - every USB cable unplugged |
| 11 | 00:08:13.121 - 00:08:50.760 | 2 | OLED and LEDs | sheet `03_parts_identification` | gates G7, G9 | ALL POWER OFF - every USB cable unplugged |
| 12 | 00:08:50.760 - 00:09:17.280 | 2 | Buttons and resistors | sheet `03_parts_identification` | gates G8, G13 | ALL POWER OFF - every USB cable unplugged |
| 13 | 00:09:17.280 - 00:09:57.993 | 2 | Buzzer and transistor | sheet `03_parts_identification` | gates G10, G11 | ALL POWER OFF - every USB cable unplugged |
| 14 | 00:09:57.993 - 00:10:21.783 | 2 | Unresolved items | text card: Resolve or record these before wiring | - | ALL POWER OFF - every USB cable unplugged |
| 15 | 00:10:21.783 - 00:10:50.867 | 3 | Place ESP1 and TRX1 | sheet `04_breadboard_placement` | gates G3, G14 | ALL POWER OFF - every USB cable unplugged |
| 16 | 00:10:50.867 - 00:11:12.543 | 3 | Node 1 pin plan | Node 1 diagram, 0 wires placed | Node 1 uses four ESP32 pins | ALL POWER OFF - every USB cable unplugged |
| 17 | 00:11:12.543 - 00:12:01.319 | 3 | N1-01 | Node 1 diagram, 0 wires placed, highlight **N1-01** | ledger row N1-01 | ALL POWER OFF - every USB cable unplugged |
| 18 | 00:12:01.319 - 00:12:40.381 | 3 | N1-02 | Node 1 diagram, 1 wires placed, highlight **N1-02** | ledger row N1-02 | ALL POWER OFF - every USB cable unplugged |
| 19 | 00:12:40.381 - 00:13:27.677 | 3 | N1-03 | Node 1 diagram, 2 wires placed, highlight **N1-03** | ledger row N1-03 | ALL POWER OFF - every USB cable unplugged |
| 20 | 00:13:27.677 - 00:14:14.318 | 3 | N1-04 | Node 1 diagram, 3 wires placed, highlight **N1-04** | ledger row N1-04 | ALL POWER OFF - every USB cable unplugged |
| 21 | 00:14:14.318 - 00:14:36.464 | 3 | Node 1 complete | Node 1 diagram, 4 wires placed | Check before moving on (power off) | ALL POWER OFF - every USB cable unplugged |
| 22 | 00:14:36.464 - 00:15:23.780 | 4 | Place ESP2 and TRX2 | sheet `04_breadboard_placement` | gates G3, G14 | ALL POWER OFF - every USB cable unplugged |
| 23 | 00:15:23.780 - 00:15:45.531 | 4 | Node 2 pin plan | Node 2 diagram, 0 wires placed | Node 2 uses four ESP32 pins | ALL POWER OFF - every USB cable unplugged |
| 24 | 00:15:45.531 - 00:16:32.587 | 4 | N2-01 | Node 2 diagram, 0 wires placed, highlight **N2-01** | ledger row N2-01 | ALL POWER OFF - every USB cable unplugged |
| 25 | 00:16:32.587 - 00:17:11.723 | 4 | N2-02 | Node 2 diagram, 1 wires placed, highlight **N2-02** | ledger row N2-02 | ALL POWER OFF - every USB cable unplugged |
| 26 | 00:17:11.723 - 00:17:59.044 | 4 | N2-03 | Node 2 diagram, 2 wires placed, highlight **N2-03** | ledger row N2-03 | ALL POWER OFF - every USB cable unplugged |
| 27 | 00:17:59.044 - 00:18:45.706 | 4 | N2-04 | Node 2 diagram, 3 wires placed, highlight **N2-04** | ledger row N2-04 | ALL POWER OFF - every USB cable unplugged |
| 28 | 00:18:45.706 - 00:19:07.871 | 4 | Node 2 complete | Node 2 diagram, 4 wires placed | Check before moving on (power off) | ALL POWER OFF - every USB cable unplugged |
| 29 | 00:19:07.871 - 00:19:43.190 | 5 | Place Node 3 | sheet `04_breadboard_placement` | gates G3, G14 | ALL POWER OFF - every USB cable unplugged |
| 30 | 00:19:43.190 - 00:20:26.200 | 5 | N3-01 | Node 3 diagram, 0 wires placed, highlight **N3-01** | ledger row N3-01 | ALL POWER OFF - every USB cable unplugged |
| 31 | 00:20:26.200 - 00:21:08.107 | 5 | N3-02 | Node 3 diagram, 1 wires placed, highlight **N3-02** | ledger row N3-02 | ALL POWER OFF - every USB cable unplugged |
| 32 | 00:21:08.107 - 00:21:53.088 | 5 | N3-03 | Node 3 diagram, 2 wires placed, highlight **N3-03** | ledger row N3-03 | ALL POWER OFF - every USB cable unplugged |
| 33 | 00:21:53.088 - 00:22:31.944 | 5 | N3-04 | Node 3 diagram, 3 wires placed, highlight **N3-04** | ledger row N3-04 | ALL POWER OFF - every USB cable unplugged |
| 34 | 00:22:31.944 - 00:23:07.386 | 5 | N3-05 | Node 3 diagram, 4 wires placed, highlight **N3-05** | ledger row N3-05 | ALL POWER OFF - every USB cable unplugged |
| 35 | 00:23:07.386 - 00:23:54.532 | 5 | N3-06 | Node 3 diagram, 5 wires placed, highlight **N3-06** | ledger row N3-06 | ALL POWER OFF - every USB cable unplugged |
| 36 | 00:23:54.532 - 00:24:40.944 | 5 | N3-07 | Node 3 diagram, 6 wires placed, highlight **N3-07** | ledger row N3-07 | ALL POWER OFF - every USB cable unplugged |
| 37 | 00:24:40.944 - 00:25:07.804 | 5 | OLED | Node 3 diagram, 7 wires placed | gates G7 | ALL POWER OFF - every USB cable unplugged |
| 38 | 00:25:07.804 - 00:25:47.920 | 5 | N3-10 | Node 3 diagram, 7 wires placed, highlight **N3-10** | ledger row N3-10 | ALL POWER OFF - every USB cable unplugged |
| 39 | 00:25:47.920 - 00:26:22.307 | 5 | N3-11 | Node 3 diagram, 8 wires placed, highlight **N3-11** | ledger row N3-11 | ALL POWER OFF - every USB cable unplugged |
| 40 | 00:26:22.307 - 00:27:06.673 | 5 | N3-12 | Node 3 diagram, 9 wires placed, highlight **N3-12** | ledger row N3-12 | ALL POWER OFF - every USB cable unplugged |
| 41 | 00:27:06.673 - 00:27:51.654 | 5 | N3-13 | Node 3 diagram, 10 wires placed, highlight **N3-13** | ledger row N3-13 | ALL POWER OFF - every USB cable unplugged |
| 42 | 00:27:51.654 - 00:28:14.374 | 5 | LED circuits | Node 3 diagram, 11 wires placed | Three separate LED circuits | ALL POWER OFF - every USB cable unplugged |
| 43 | 00:28:14.374 - 00:29:01.620 | 5 | N3-14 | Node 3 diagram, 11 wires placed, highlight **N3-14** | ledger row N3-14 | ALL POWER OFF - every USB cable unplugged |
| 44 | 00:29:01.620 - 00:29:41.491 | 5 | N3-15 | Node 3 diagram, 12 wires placed, highlight **N3-15** | ledger row N3-15 | ALL POWER OFF - every USB cable unplugged |
| 45 | 00:29:41.491 - 00:30:20.158 | 5 | N3-16 | Node 3 diagram, 13 wires placed, highlight **N3-16** | ledger row N3-16 | ALL POWER OFF - every USB cable unplugged |
| 46 | 00:30:20.158 - 00:31:07.688 | 5 | N3-17 | Node 3 diagram, 14 wires placed, highlight **N3-17** | ledger row N3-17 | ALL POWER OFF - every USB cable unplugged |
| 47 | 00:31:07.688 - 00:31:45.385 | 5 | N3-18 | Node 3 diagram, 15 wires placed, highlight **N3-18** | ledger row N3-18 | ALL POWER OFF - every USB cable unplugged |
| 48 | 00:31:45.385 - 00:32:20.867 | 5 | N3-19 | Node 3 diagram, 16 wires placed, highlight **N3-19** | ledger row N3-19 | ALL POWER OFF - every USB cable unplugged |
| 49 | 00:32:20.867 - 00:33:08.027 | 5 | N3-20 | Node 3 diagram, 17 wires placed, highlight **N3-20** | ledger row N3-20 | ALL POWER OFF - every USB cable unplugged |
| 50 | 00:33:08.027 - 00:33:45.489 | 5 | N3-21 | Node 3 diagram, 18 wires placed, highlight **N3-21** | ledger row N3-21 | ALL POWER OFF - every USB cable unplugged |
| 51 | 00:33:45.489 - 00:34:20.856 | 5 | N3-22 | Node 3 diagram, 19 wires placed, highlight **N3-22** | ledger row N3-22 | ALL POWER OFF - every USB cable unplugged |
| 52 | 00:34:20.856 - 00:34:42.132 | 5 | Buttons | Node 3 diagram, 20 wires placed | gates G8 | ALL POWER OFF - every USB cable unplugged |
| 53 | 00:34:42.132 - 00:35:25.913 | 5 | N3-23 | Node 3 diagram, 20 wires placed, highlight **N3-23** | ledger row N3-23 | ALL POWER OFF - every USB cable unplugged |
| 54 | 00:35:25.913 - 00:36:04.275 | 5 | N3-24 | Node 3 diagram, 21 wires placed, highlight **N3-24** | ledger row N3-24 | ALL POWER OFF - every USB cable unplugged |
| 55 | 00:36:04.275 - 00:36:48.501 | 5 | N3-25 | Node 3 diagram, 22 wires placed, highlight **N3-25** | ledger row N3-25 | ALL POWER OFF - every USB cable unplugged |
| 56 | 00:36:48.501 - 00:37:24.054 | 5 | N3-26 | Node 3 diagram, 23 wires placed, highlight **N3-26** | ledger row N3-26 | ALL POWER OFF - every USB cable unplugged |
| 57 | 00:37:24.054 - 00:38:11.374 | 5 | Buzzer driver design | Node 3 diagram, 24 wires placed | Low-side NPN switch (reviewed) | ALL POWER OFF - every USB cable unplugged |
| 58 | 00:38:11.374 - 00:39:21.421 | 5 | N3-27 | Node 3 diagram, 24 wires placed, highlight **N3-27** | ledger row N3-27 | ALL POWER OFF - every USB cable unplugged |
| 59 | 00:39:21.421 - 00:40:02.543 | 5 | N3-28 | Node 3 diagram, 25 wires placed, highlight **N3-28** | ledger row N3-28 | ALL POWER OFF - every USB cable unplugged |
| 60 | 00:40:02.543 - 00:40:41.260 | 5 | N3-29 | Node 3 diagram, 26 wires placed, highlight **N3-29** | ledger row N3-29 | ALL POWER OFF - every USB cable unplugged |
| 61 | 00:40:41.260 - 00:41:20.937 | 5 | N3-30 | Node 3 diagram, 27 wires placed, highlight **N3-30** | ledger row N3-30 | ALL POWER OFF - every USB cable unplugged |
| 62 | 00:41:20.937 - 00:41:56.444 | 5 | N3-31 | Node 3 diagram, 28 wires placed, highlight **N3-31** | ledger row N3-31 | ALL POWER OFF - every USB cable unplugged |
| 63 | 00:41:56.444 - 00:42:33.891 | 5 | N3-32 | Node 3 diagram, 29 wires placed, highlight **N3-32** | ledger row N3-32 | ALL POWER OFF - every USB cable unplugged |
| 64 | 00:42:33.891 - 00:43:11.858 | 5 | N3-33 | Node 3 diagram, 30 wires placed, highlight **N3-33** | ledger row N3-33 | ALL POWER OFF - every USB cable unplugged |
| 65 | 00:43:11.858 - 00:43:45.065 | 5 | N3-34 | Node 3 diagram, 31 wires placed, highlight **N3-34** | ledger row N3-34 | ALL POWER OFF - every USB cable unplugged |
| 66 | 00:43:45.065 - 00:44:04.407 | 5 | Node 3 complete (buzzer supply deferred) | Node 3 diagram, 32 wires placed | State of Node 3 | ALL POWER OFF - every USB cable unplugged |
| 67 | 00:44:04.407 - 00:44:33.216 | 6 | Bus topology | bus diagram | Why a line, not a star | ALL POWER OFF - every USB cable unplugged |
| 68 | 00:44:33.216 - 00:44:59.976 | 6 | Terminator decision | bus diagram | gates G6, G13 | ALL POWER OFF - every USB cable unplugged |
| 69 | 00:44:59.976 - 00:45:43.146 | 6 | N1-05 | bus diagram, highlight **N1-05** | ledger row N1-05 | ALL POWER OFF - every USB cable unplugged |
| 70 | 00:45:43.146 - 00:46:27.207 | 6 | N1-06 | bus diagram, highlight **N1-06** | ledger row N1-06 | ALL POWER OFF - every USB cable unplugged |
| 71 | 00:46:27.207 - 00:47:07.113 | 6 | B-01 | bus diagram, highlight **B-01** | ledger row B-01 | ALL POWER OFF - every USB cable unplugged |
| 72 | 00:47:07.113 - 00:47:45.400 | 6 | B-02 | bus diagram, highlight **B-02** | ledger row B-02 | ALL POWER OFF - every USB cable unplugged |
| 73 | 00:47:45.400 - 00:48:20.373 | 6 | B-03 | bus diagram, highlight **B-03** | ledger row B-03 | ALL POWER OFF - every USB cable unplugged |
| 74 | 00:48:20.373 - 00:49:04.238 | 6 | B-04 | bus diagram, highlight **B-04** | ledger row B-04 | ALL POWER OFF - every USB cable unplugged |
| 75 | 00:49:04.238 - 00:49:50.673 | 6 | B-05 | bus diagram, highlight **B-05** | ledger row B-05 | ALL POWER OFF - every USB cable unplugged |
| 76 | 00:49:50.673 - 00:50:28.299 | 6 | B-06 | bus diagram, highlight **B-06** | ledger row B-06 | ALL POWER OFF - every USB cable unplugged |
| 77 | 00:50:28.299 - 00:51:11.605 | 6 | N3-08 | bus diagram, highlight **N3-08** | ledger row N3-08 | ALL POWER OFF - every USB cable unplugged |
| 78 | 00:51:11.605 - 00:51:55.840 | 6 | N3-09 | bus diagram, highlight **N3-09** | ledger row N3-09 | ALL POWER OFF - every USB cable unplugged |
| 79 | 00:51:55.840 - 00:52:11.612 | 6 | Bus complete | bus diagram | The finished bus | ALL POWER OFF - every USB cable unplugged |
| 80 | 00:52:11.612 - 00:52:30.384 | 7 | Ledger walk-through | text card: Check every wire against the ledger | - | ALL POWER OFF - every USB cable unplugged |
| 81 | 00:52:30.384 - 00:52:57.203 | 7 | Rail short check | meter illustration (rails) | Supply short check (power off) | ALL POWER OFF - every USB cable unplugged |
| 82 | 00:52:57.203 - 00:53:16.600 | 7 | CAN continuity and polarity | meter illustration (canpol) | CANH / CANL continuity (power off) | ALL POWER OFF - every USB cable unplugged |
| 83 | 00:53:16.600 - 00:53:50.442 | 7 | Termination resistance | meter illustration (term) | CANH to CANL, whole bus, power off | ALL POWER OFF - every USB cable unplugged |
| 84 | 00:53:50.442 - 00:54:14.917 | 7 | Buzzer and 5 V checks | Node 3 diagram, 32 wires placed | Final safety checks | ALL POWER OFF - every USB cable unplugged |
| 85 | 00:54:14.917 - 00:54:49.456 | 8 | Power-up rules | text card: First power-up: one node at a time | - | ALL POWER OFF - every USB cable unplugged |
| 86 | 00:54:49.456 - 00:55:17.690 | 8 | Node 1 alone | meter illustration (power1) | Node 1 single power-up | Node 1 USB ONLY |
| 87 | 00:55:17.690 - 00:55:56.637 | 8 | Node 2 alone | meter illustration (power2) | Node 2 single power-up | Node 2 USB ONLY |
| 88 | 00:55:56.637 - 00:56:36.754 | 8 | Node 3 alone | meter illustration (power3) | Node 3 single power-up | Node 3 USB ONLY |
| 89 | 00:56:36.754 - 00:57:36.697 | 8 | N3-35 (deferred) | Node 3 diagram, 32 wires placed, highlight **N3-35** | ledger row N3-35 | ALL POWER OFF - every USB cable unplugged |
| 90 | 00:57:36.697 - 00:57:59.977 | 9 | Compile is not communication | text card: What counts as evidence | - | ALL POWER OFF - every USB cable unplugged |
| 91 | 00:57:59.977 - 00:58:40.390 | 9 | Two-node test | bus diagram | Node 1 + Node 2 (Node 3 unplugged) | Node 1 + Node 2 USB |
| 92 | 00:58:40.390 - 00:59:07.554 | 9 | Three-node test | bus diagram | Add Node 3 (monitor, listen-only) | All three USB |
| 93 | 00:59:07.554 - 00:59:22.906 | 10 | All nodes | sheet `07_node3_wiring` | Handover | Unplug before handling |
| 94 | 00:59:22.906 - 00:59:57.079 | 10 | Tested vs untested | text card: What has actually been verified | - | ALL POWER OFF - every USB cable unplugged |
