Naveen-kumar14/CanScope/docs/wiring/diagrams/03_parts_identification.png

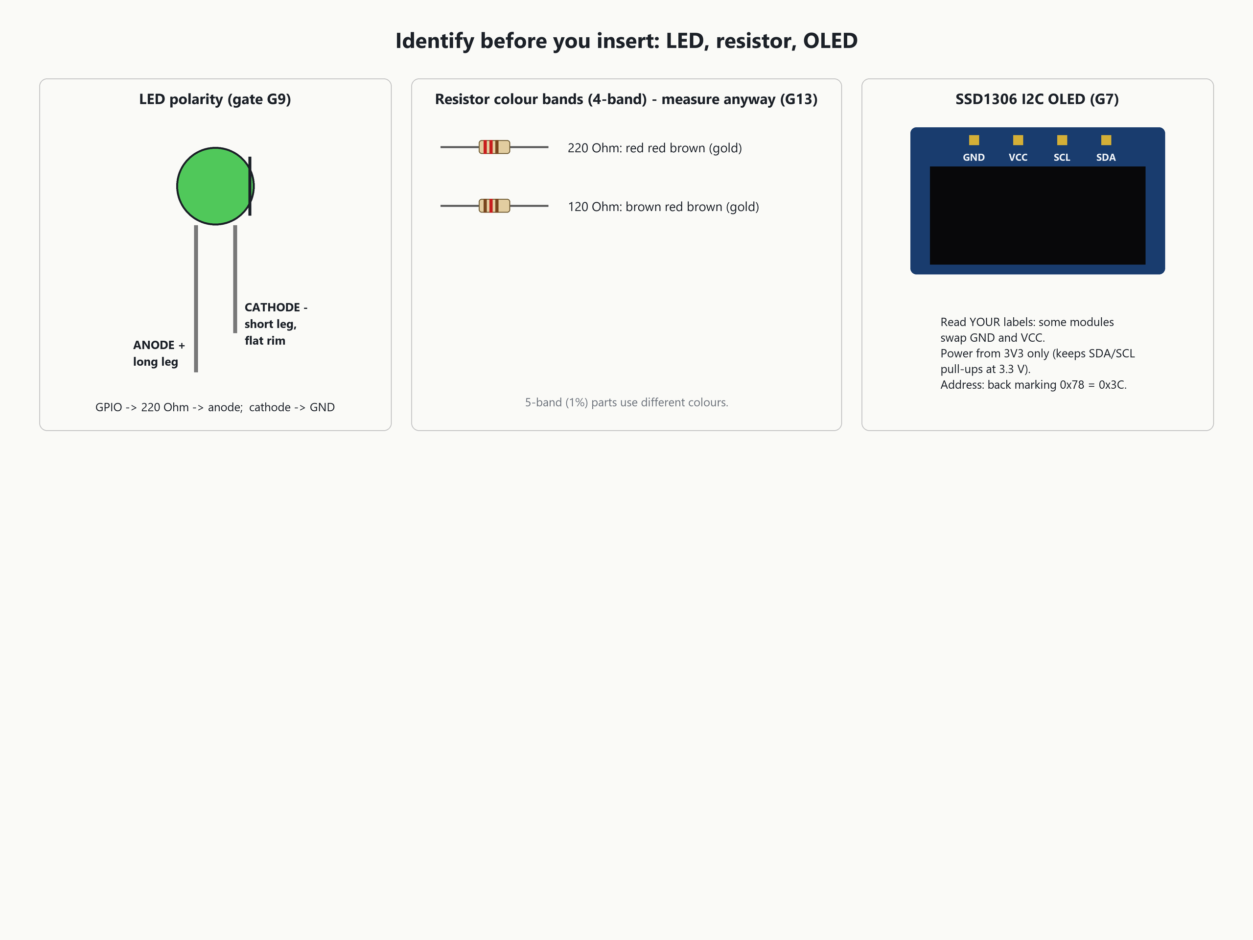
docs/wiring/diagrams/03_parts_identification.png
