Naveen-kumar14/CanScope/docs/wiring/diagrams/02_transceiver_identification.png

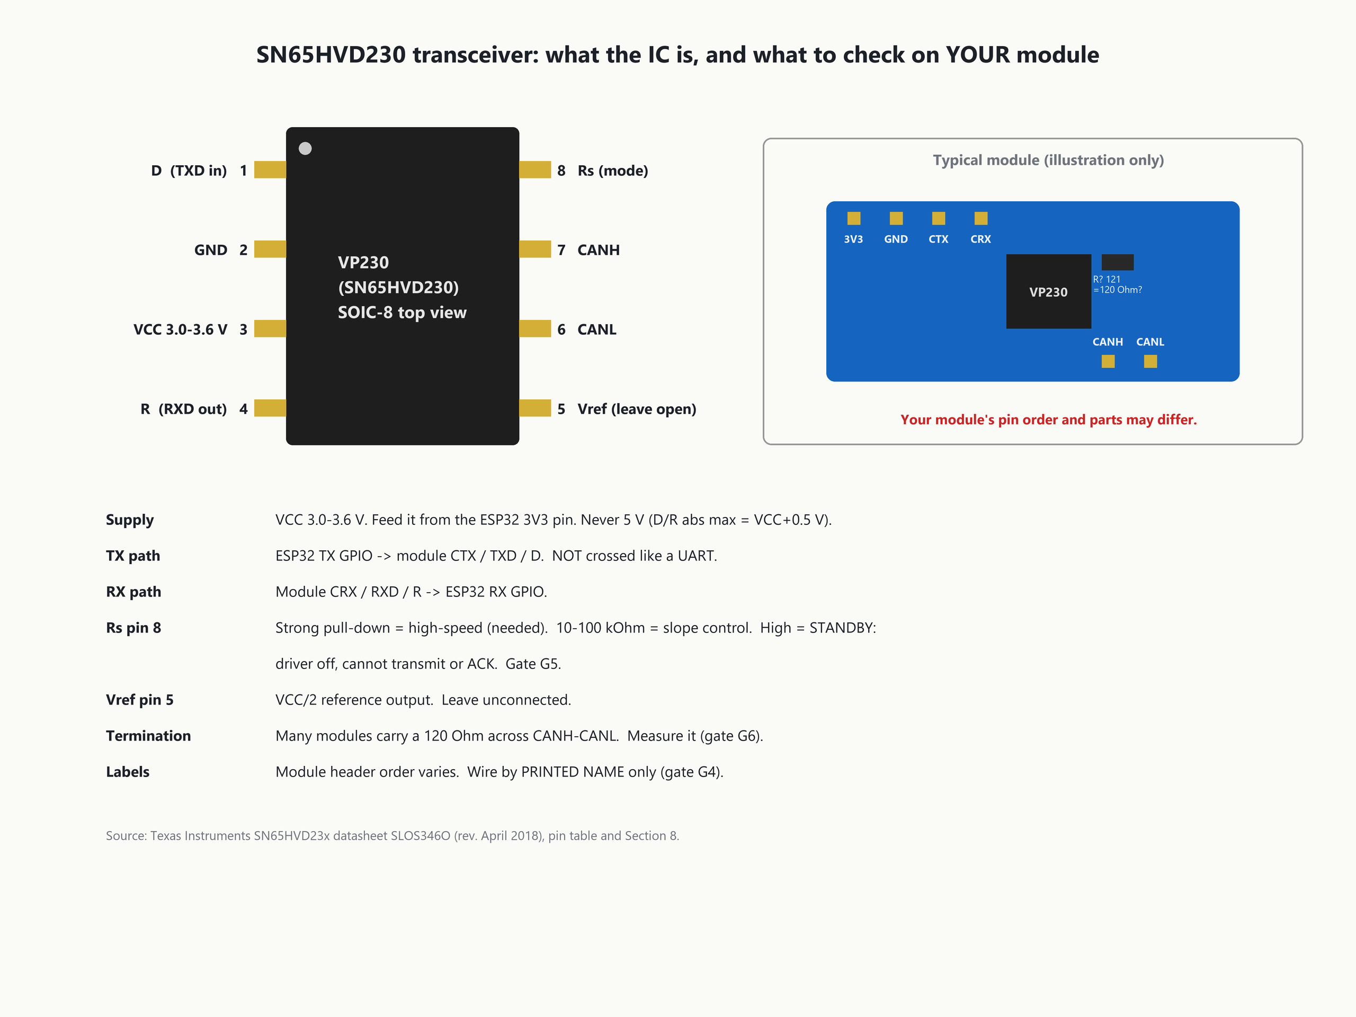
docs/wiring/diagrams/02_transceiver_identification.png
