Naveen-kumar14/CanScope/docs/wiring/diagrams/05_node1_wiring.png

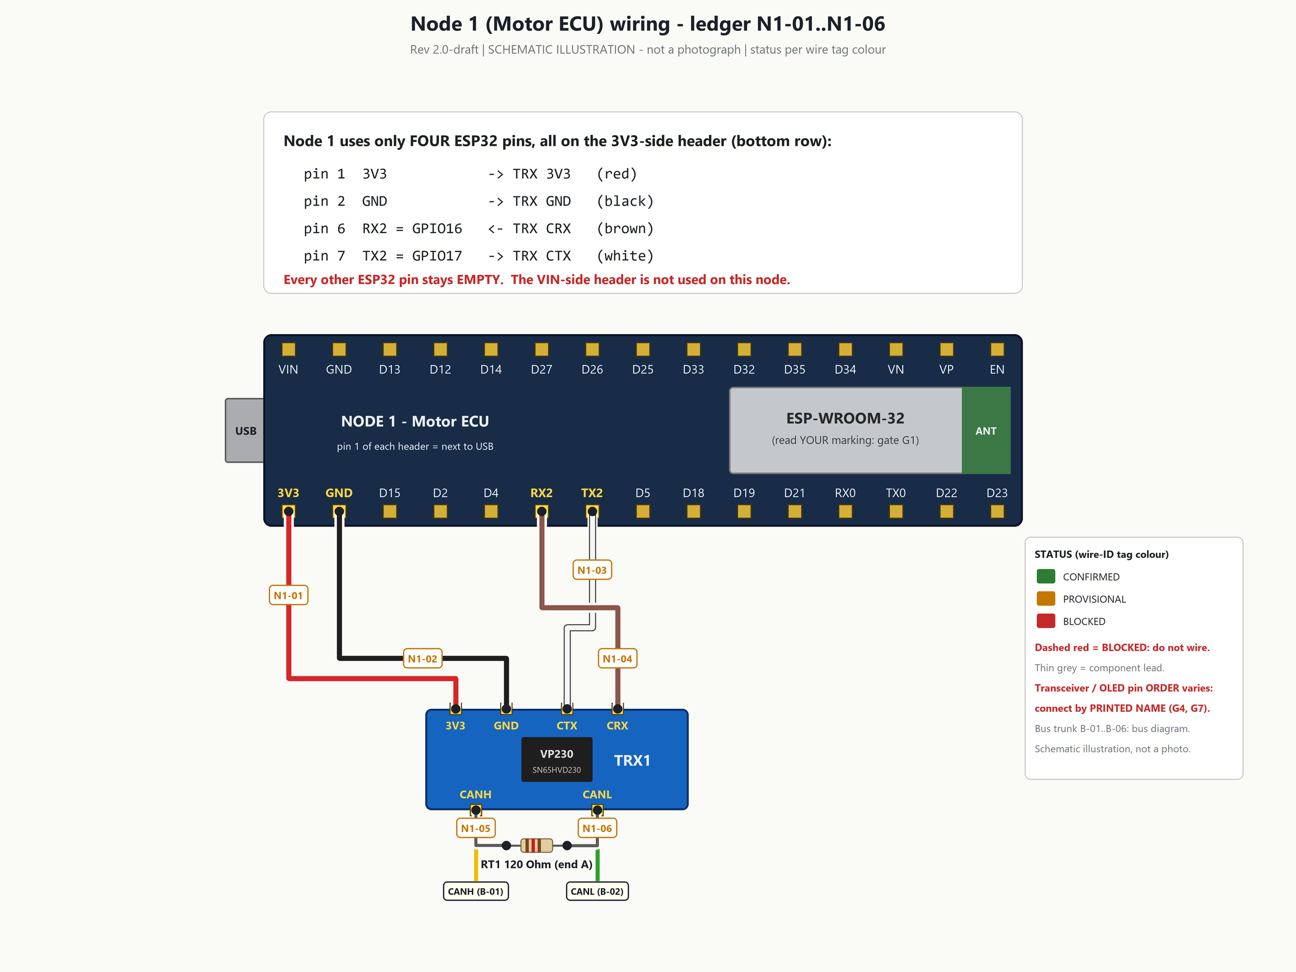
docs/wiring/diagrams/05_node1_wiring.png
