Naveen-kumar14/CanScope/docs/wiring/diagrams/07_node3_wiring.png

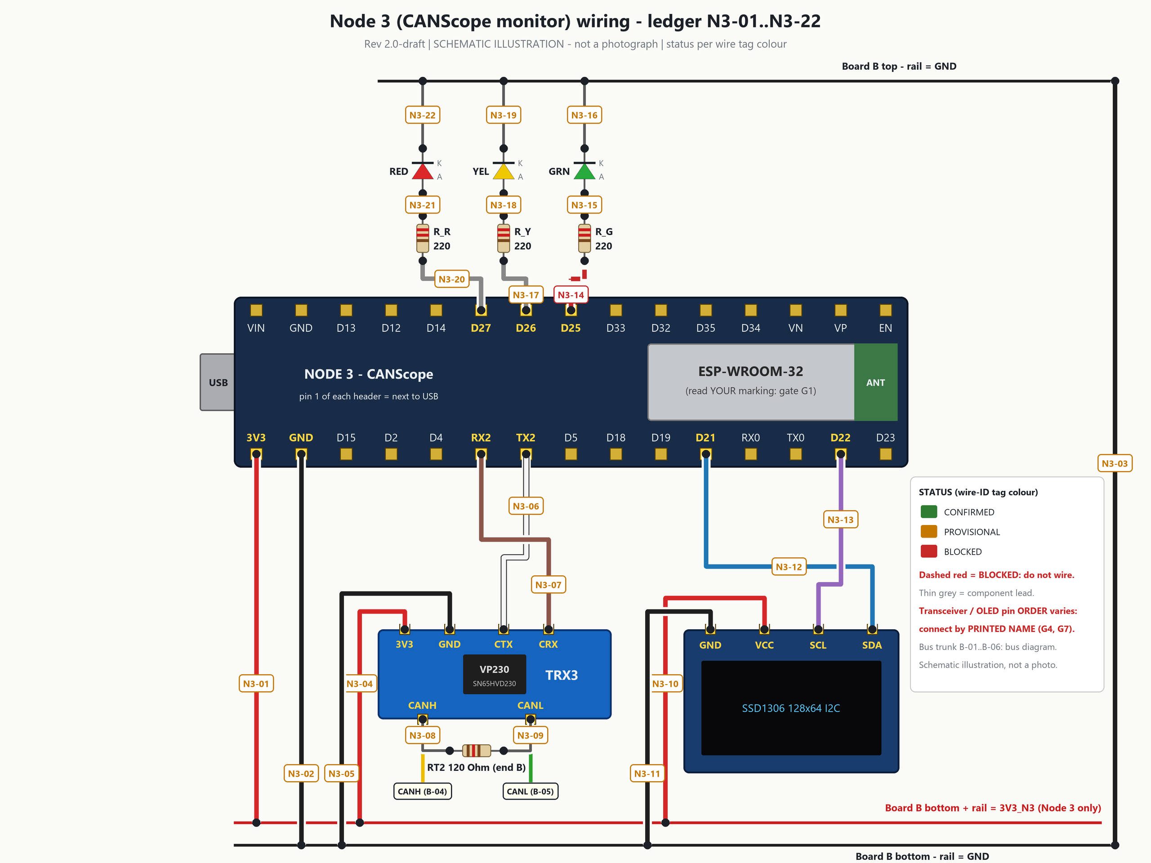
docs/wiring/diagrams/07_node3_wiring.png
