Naveen-kumar14/CanScope/test/integration/README.md

# Integration / bench tests

No integration test has been run yet. These need real hardware and are run by a person, in the order in `docs/testing.md` (inventory → power/continuity → loopback → two-node bus → Node 3 → fault tests).

Record each run in `TASK.md` with: date, boards and transceivers used (with part numbers), wiring reference, firmware env and commit, exact commands, captured serial log (save it in `captures/`), and the result.
