Naveen-kumar14/CanScope/validation/wire_coverage_checklist.md

# Wire coverage checklist and sign-off

Generated by `tools/hwdocs/validate.py` from `docs/wiring/pin_ledger.json` (Rev 2.0-draft). Do not edit by hand.

Use it twice: (1) the coverage columns prove that every ledger row is drawn and shown in the video; (2) the last three columns are the builder's sign-off, filled in on paper with **all power off**.

Status: **CONFIRMED** documents support it · **PROVISIONAL** wire only after its gates pass · **BLOCKED** leave empty.

| ID | From | To | Signal | Wire | Status | Gates | Check (power off) | Diagram | Video step | Gates passed | Both ends + meter | Initials |
|---|---|---|---|---|---|---|---|---|---|---|---|---|
| N1-01 | ESP1 3V3, 3V3-side pin 1 from USB | TRX1 3V3 | 3V3_N1 | red | **PROVISIONAL** | G1, G2, G4 | Power off: continuity ESP1 3V3 pin to TRX1 3V3 pin; no continuity to any GND or 5 V point. | node1 | 16 | ☐ | ☐ | |
| N1-02 | ESP1 GND, 3V3-side pin 2 from USB | TRX1 GND | GND | black | **PROVISIONAL** | G2, G4 | Continuity ESP1 GND to TRX1 GND. | node1 | 17 | ☐ | ☐ | |
| N1-03 | ESP1 TX2 (GPIO17), 3V3-side pin 7 from USB | TRX1 CTX | CAN_TX_N1 (GPIO17) | white | **PROVISIONAL** | G1, G2, G4 | Continuity TX2 pin to CTX pin; NOT to CRX. | node1 | 18 | ☐ | ☐ | |
| N1-04 | ESP1 RX2 (GPIO16), 3V3-side pin 6 from USB | TRX1 CRX | CAN_RX_N1 (GPIO16) | brown | **PROVISIONAL** | G1, G2, G4 | Continuity RX2 pin to CRX pin; NOT to CTX. | node1 | 19 | ☐ | ☐ | |
| N1-05 | RT1 1 | TRX1 CANH | CANH (end A terminator) | lead | **PROVISIONAL** | G6, G13 | Fit only if G6 found no onboard terminator on TRX1. | node1, bus | 54 | ☐ | ☐ | |
| N1-06 | RT1 2 | TRX1 CANL | CANL (end A terminator) | lead | **PROVISIONAL** | G6, G13 | RT1 measured 114-126 Ohm before fitting. | node1, bus | 55 | ☐ | ☐ | |
| N2-01 | ESP2 3V3, 3V3-side pin 1 from USB | TRX2 3V3 | 3V3_N2 | red | **PROVISIONAL** | G1, G2, G4 | Continuity ESP2 3V3 to TRX2 3V3. NO continuity to Node 1 3V3. | node2 | 23 | ☐ | ☐ | |
| N2-02 | ESP2 GND, 3V3-side pin 2 from USB | TRX2 GND | GND | black | **PROVISIONAL** | G2, G4 | Continuity ESP2 GND to TRX2 GND. | node2 | 24 | ☐ | ☐ | |
| N2-03 | ESP2 TX2 (GPIO17), 3V3-side pin 7 from USB | TRX2 CTX | CAN_TX_N2 (GPIO17) | white | **PROVISIONAL** | G1, G2, G4 | Continuity TX2 pin to CTX pin; NOT to CRX. | node2 | 25 | ☐ | ☐ | |
| N2-04 | ESP2 RX2 (GPIO16), 3V3-side pin 6 from USB | TRX2 CRX | CAN_RX_N2 (GPIO16) | brown | **PROVISIONAL** | G1, G2, G4 | Continuity RX2 pin to CRX pin; NOT to CTX. | node2 | 26 | ☐ | ☐ | |
| N3-01 | ESP3 3V3, 3V3-side pin 1 from USB | Board B bottom + rail (3V3_N3) | 3V3_N3 | red | **PROVISIONAL** | G2, G14 | Continuity 3V3 pin to bottom + rail. | node3 | 29 | ☐ | ☐ | |
| N3-02 | ESP3 GND, 3V3-side pin 2 from USB | Board B bottom - rail (GND) | GND | black | **PROVISIONAL** | G2, G14 | Continuity GND pin (3V3 side) to bottom - rail. | node3 | 30 | ☐ | ☐ | |
| N3-03 | Board B bottom - rail (GND) | Board B top - rail (GND) | GND (rail link, far right end of board B) | black | **PROVISIONAL** | G14 | Continuity bottom - rail to top - rail: near 0 Ohm. Never link a - rail to a + rail. | node3 | 31 | ☐ | ☐ | |
| N3-04 | Board B bottom + rail (3V3_N3) | TRX3 3V3 | 3V3_N3 | red | **PROVISIONAL** | G4 | Continuity + rail to TRX3 3V3. | node3 | 32 | ☐ | ☐ | |
| N3-05 | Board B bottom - rail (GND) | TRX3 GND | GND | black | **PROVISIONAL** | G4 | Continuity - rail to TRX3 GND. | node3 | 33 | ☐ | ☐ | |
| N3-06 | ESP3 TX2 (GPIO17), 3V3-side pin 7 from USB | TRX3 CTX | CAN_TX_N3 (GPIO17) | white | **PROVISIONAL** | G1, G2, G4 | Continuity TX2 to CTX; NOT to CRX. | node3 | 34 | ☐ | ☐ | |
| N3-07 | ESP3 RX2 (GPIO16), 3V3-side pin 6 from USB | TRX3 CRX | CAN_RX_N3 (GPIO16) | brown | **PROVISIONAL** | G1, G2, G4 | Continuity RX2 to CRX; NOT to CTX. | node3 | 35 | ☐ | ☐ | |
| N3-08 | RT2 1 | TRX3 CANH | CANH (end B terminator) | lead | **PROVISIONAL** | G6, G13 | Fit only if G6 found no onboard terminator on TRX3. | node3, bus | 62 | ☐ | ☐ | |
| N3-09 | RT2 2 | TRX3 CANL | CANL (end B terminator) | lead | **PROVISIONAL** | G6, G13 | RT2 measured 114-126 Ohm before fitting. | node3, bus | 63 | ☐ | ☐ | |
| N3-10 | Board B bottom + rail (3V3_N3) | OLED VCC | 3V3_N3 | red | **PROVISIONAL** | G7 | Continuity + rail to the pin PRINTED VCC/VDD (not by position). | node3 | 37 | ☐ | ☐ | |
| N3-11 | Board B bottom - rail (GND) | OLED GND | GND | black | **PROVISIONAL** | G7 | Continuity - rail to the pin PRINTED GND. | node3 | 38 | ☐ | ☐ | |
| N3-12 | ESP3 D21 (GPIO21), 3V3-side pin 11 from USB | OLED SDA | I2C_SDA (GPIO21) | blue | **PROVISIONAL** | G2, G7 | Continuity D21 to SDA; NOT to SCL. | node3 | 39 | ☐ | ☐ | |
| N3-13 | ESP3 D22 (GPIO22), 3V3-side pin 14 from USB | OLED SCL | I2C_SCL (GPIO22) | purple | **PROVISIONAL** | G2, G7 | Continuity D22 to SCL; NOT to SDA. | node3 | 40 | ☐ | ☐ | |
| N3-14 | ESP3 D25 (GPIO25), VIN-side pin 8 from USB | R_G 1 | LED_GREEN (GPIO25) | grey | **BLOCKED** | G2, G13 | Do NOT wire. The green LED has no verified pin (GPIO25 was proposed but not confirmed). Firmware leaves the green LED disabled until a verified GPIO is recorded here. | node3 | 42 | n/a - do not wire | ☐ empty | |
| N3-15 | R_G 2 | LED_G A | LED_GREEN via 220 | lead | **PROVISIONAL** | G9 | Resistor and anode share one 5-hole strip; nothing else in it. | node3 | 43 | ☐ | ☐ | |
| N3-16 | LED_G K | Board B top - rail (GND) | GND | lead | **PROVISIONAL** | G9, G14 | Cathode (short leg, flat side) to top GND rail. | node3 | 44 | ☐ | ☐ | |
| N3-17 | ESP3 D26 (GPIO26), VIN-side pin 7 from USB | R_Y 1 | LED_YELLOW (GPIO26) | grey | **PROVISIONAL** | G2, G13 | Continuity D26 to one end of the yellow 220 Ohm. | node3 | 45 | ☐ | ☐ | |
| N3-18 | R_Y 2 | LED_Y A | LED_YELLOW via 220 | lead | **PROVISIONAL** | G9 | Resistor and anode share one strip. | node3 | 46 | ☐ | ☐ | |
| N3-19 | LED_Y K | Board B top - rail (GND) | GND | lead | **PROVISIONAL** | G9, G14 | Cathode to top GND rail. | node3 | 47 | ☐ | ☐ | |
| N3-20 | ESP3 D27 (GPIO27), VIN-side pin 6 from USB | R_R 1 | LED_RED (GPIO27) | grey | **PROVISIONAL** | G2, G13 | Continuity D27 to one end of the red 220 Ohm. | node3 | 48 | ☐ | ☐ | |
| N3-21 | R_R 2 | LED_R A | LED_RED via 220 | lead | **PROVISIONAL** | G9 | Resistor and anode share one strip. | node3 | 49 | ☐ | ☐ | |
| N3-22 | LED_R K | Board B top - rail (GND) | GND | lead | **PROVISIONAL** | G9, G14 | Cathode to top GND rail. | node3 | 50 | ☐ | ☐ | |
| B-01 | TRX1 CANH | TRX2 CANH | CANH trunk, segment 1 | yellow | **PROVISIONAL** | G4 | Continuity TRX1 CANH to TRX2 CANH; no continuity CANH to CANL other than through terminators. | bus | 56 | ☐ | ☐ | |
| B-02 | TRX1 CANL | TRX2 CANL | CANL trunk, segment 1 | green | **PROVISIONAL** | G4 | Twist with B-01. Continuity TRX1 CANL to TRX2 CANL. | bus | 57 | ☐ | ☐ | |
| B-03 | TRX1 GND | TRX2 GND | GND reference, segment 1 | black | **PROVISIONAL** | G4 | Continuity Node 1 GND to Node 2 GND. | bus | 58 | ☐ | ☐ | |
| B-04 | TRX2 CANH | TRX3 CANH | CANH trunk, segment 2 (board A to B) | yellow | **PROVISIONAL** | G4 | Continuity TRX2 CANH to TRX3 CANH. | bus | 59 | ☐ | ☐ | |
| B-05 | TRX2 CANL | TRX3 CANL | CANL trunk, segment 2 (board A to B) | green | **PROVISIONAL** | G4 | Twist with B-04. Continuity TRX2 CANL to TRX3 CANL. | bus | 60 | ☐ | ☐ | |
| B-06 | TRX2 GND | Board B bottom - rail (GND) | GND reference, segment 2 | black | **PROVISIONAL** | G4, G14 | Continuity Node 2 GND to Node 3 GND rail. | bus | 61 | ☐ | ☐ | |

## Conditional rows (apply only if the condition is true)

| ID | Applies when | From | To | Signal | Status | Gates |
|---|---|---|---|---|---|---|
| C-RS1 | Only if TRX1 exposes a pin labelled RS, S or STB | TRX1:RS | TRX1:GND | Rs = high-speed mode | **PROVISIONAL** | G4, G5 |
| C-RS2 | Only if TRX2 exposes a pin labelled RS, S or STB | TRX2:RS | TRX2:GND | Rs = high-speed mode | **PROVISIONAL** | G4, G5 |
| C-RS3 | Only if TRX3 exposes a pin labelled RS, S or STB | TRX3:RS | RAIL3:GND- | Rs = high-speed mode | **PROVISIONAL** | G4, G5 |
| C-VREF | Any module exposing Vref | TRXn:Vref | (no connection) | leave unconnected | **CONFIRMED** |  |
| C-T2 | If G6 finds an onboard 120 Ohm on TRX2 (middle node) | TRX2 onboard terminator | (remove / open jumper) | prevents a third terminator | **BLOCKED** | G6 |

## Gate record

| Gate | Title | Pass condition | Result / value | Date | Initials |
|---|---|---|---|---|---|
| G1 | ESP32 module identity | It reads ESP32-WROOM-32 (or WROOM-32D/32E/32U). Not WROVER, not ESP32-S2/S3/C3. | | | |
| G2 | Header silkscreen matches the ledger | All 30 labels match in the same order. | | | |
| G3 | Breadboard fit | At least one free hole remains in the same 5-hole strip as every pin, on both sides. | | | |
| G4 | Transceiver module identity and labels | IC reads VP230; supply pin is labelled 3V3/3.3V/VCC with no 5 V-only marking; you can find pins equivalent to 3V3, GND, CTX (TXD/D), CRX (RXD/R), CANH, CANL. | | | |
| G5 | Transceiver Rs (mode) pin | Exposed RS pin wired to GND, OR measured Rs-GND below 100 Ohm (high-speed mode per TI SLOS346O). | | | |
| G6 | Onboard termination | Reading above 10 kOhm (no onboard terminator) on all three modules: fit RT1 and RT2 exactly as the ledger says. | | | |
| G7 | OLED labels | Labels GND, VCC (or VDD), SCL (or SCK), SDA are present; record their order and address. | | | |
| G9 | LED polarity | Anode and cathode identified for every LED. | | | |
| G13 | Resistor values | 220 Ohm: 209-231; 120 Ohm: 114-126; 1 kOhm: 950-1050; 10 kOhm: 9.5k-10.5k. | | | |
| G14 | Breadboard rails | Continuous end to end, or the split point is marked. | | | |
