Naveen-kumar14/CanScope/validation/correction_register.md

# Correction register: CANScope Physical Build Manual Rev 1.0 → Rev 2.0-draft

Audited: `CANScope_Physical_Build_Manual.pdf` (Rev 1.0, 16 Oct 2026, 12 pages, SHA-256 `5DF01044…96589`), plus the repository at commit `90f78c9`.
Auditor: Claude (Opus 5.5), 2026-10-16. **No physical hardware was inspected, measured or powered.** All evidence is documentary.

## Evidence used

| Ref | Source | How it was obtained |
|---|---|---|
| E-TI | Texas Instruments SN65HVD23x datasheet **SLOS346O** (rev. April 2018): pin table, §8.1 abs max, §8.3 recommended conditions, §8.5 supply current, §10.3 features | Downloaded from ti.com, text extracted and read |
| E-ESP32 | Espressif *ESP32 Series Datasheet*: strapping pins (GPIO0, 2, 5, 12/MTDI, 15/MTDO), input-only GPIO34–39, internal pull-up ≈45 kΩ | Downloaded from espressif.com, text extracted |
| E-WROOM | Espressif *ESP32-WROOM-32 Datasheet* **v3.8**: pin table (IO16 = module pin 27, IO17 = pin 28, GPIO6–11 on the internal flash) | Downloaded from espressif.com, text extracted |
| E-ARD | `C:/canscope-pio/packages/framework-arduinoespressif32/variants/esp32/pins_arduino.h`: `SDA = 21`, `SCL = 22`, `TX = 1`, `RX = 3` | Read locally (the PlatformIO package the repo builds with) |
| E-FW | `firmware/node1|node2|monitor/include/*_hw_config.h`, `sketch_node1_test.ino`, `sketch_node2_test.ino`, `firmware/node3/include/node3_hw_config.h`, `firmware/common/**` | Read; GPIO values cross-checked automatically by `tools/hwdocs/ledger.py` |
| E-DOIT | Widely published DOIT ESP32 DevKit V1 30-pin silkscreen order | General reference, **not** a manufacturer schematic. Gate G2 compares it with the real board |
| E-CALC | Hand calculations (below) | — |

Limits: no photo of any of the user's modules was available. The exact transceiver module, OLED module, button package, buzzer and transistor are unidentified, so their wiring depends on bench gates G1–G14 (defined in `docs/wiring/pin_ledger.json`).

### Calculations (E-CALC)

- **LED current:** (3.3 V − V<sub>f</sub>) / 220 Ω. With V<sub>f</sub> ≈ 1.8–2.2 V that is 5.0–6.8 mA per LED, within ESP32 GPIO drive and typical 20 mA LED ratings.
- **Buzzer base drive:** I<sub>B</sub> = (3.3 − 0.75) V / 1 kΩ ≈ 2.6 mA. For I<sub>C</sub> ≤ 30 mA the forced β is ≈ 12. That saturates PN2222A / 2N3904 / BC547 / S8050 class parts (h<sub>FE</sub> well above 12 at these currents). R<sub>PD</sub> = 10 kΩ diverts 75 µA, which is negligible.
- **Termination:** 120 ‖ 120 = 60 Ω. With a third 120 Ω: 40 Ω. With 5 % parts the 60 Ω reading spans 57–63 Ω.
- **3.3 V budget per node:** ESP32 module (Wi-Fi off) plus SN65HVD230 at 17 mA max (E-TI). Node 3 adds the OLED (≈ 10–20 mA typical, unverified) and LEDs at ≤ 7 mA each. That is well within the DevKit's on-board regulator, but the regulator part is unverified.

## Corrections

Status meanings: **Confirmed** = the evidence settles it; **Provisional** = correct by documents, but it depends on a bench gate; **Blocked** = cannot be resolved without new information.

| # | Rev 1 page / section | Original statement or diagram | Problem or uncertainty | Evidence | Correction in Rev 2 | Status | Effect on diagrams / video |
|---|---|---|---|---|---|---|---|
| C01 | p.2 §1 table, row "Node 3 CAN TX/RX" | "GPIO22/21 in brief candidate; 17/16 legacy candidate … UNVERIFIED" | The brief's candidate 22/21 collides with the Arduino-ESP32 default I²C pins (SDA 21, SCL 22) that the OLED needs. The repo's `monitor` firmware, which is the firmware Node 3 hardware must run, already uses 17/16 | E-ARD, E-FW | Node 3 CAN: TX **GPIO17**, RX **GPIO16** (same as Nodes 1 and 2). I²C: SDA **GPIO21**, SCL **GPIO22** | Provisional (G1, G2) | Node 3 diagram, scene 5: N3-06/07 on TX2/RX2; N3-12/13 on D21/D22 |
| C02 | p.2 §1 rows "Node 1/2 CAN TX/RX"; p.2 "Important board cautions" | "GPIO16/17 may be occupied by PSRAM on some ESP32-WROVER boards" | True for WROVER. The user states every board is ESP-WROOM-32, and on WROOM-32 IO16/IO17 are ordinary GPIO (module pins 27/28) | E-WROOM | Keep 17/16. Add gate **G1**: read the shield marking. WROVER (or any marking other than WROOM-32) means STOP | Provisional (G1) | Scenes 2–5 show G1 before any wire |
| C03 | p.2, p.4, p.6, p.9 "STB/RS/EN" | "STB/RS/EN may change behavior… datasheet determines active level" | The SN65HVD230 has no STB or EN pin. Pin 8 is **Rs**: a strong pull-down gives high-speed mode; 10–100 kΩ gives slope control; ≥ 0.75 V<sub>CC</sub> gives standby (driver off, receiver listens only, so the node can neither transmit nor ACK). Pin 5 is **Vref** (V<sub>CC</sub>/2 output) | E-TI pin table | Rs must be low. If the module exposes RS/S/STB, wire it to GND (conditional rows C-RS1..3). Otherwise measure Rs to GND (gate **G5**). Vref stays unconnected | Confirmed (IC); Provisional per module (G5) | Transceiver identification sheet; scene 2 |
| C04 | p.2 §1 row "Transceiver identity"; p.3, p.6 | "SN65HVD230 requested… repo says part unknown"; "silicon is 3.3 V class" | Not quantified | E-TI: V<sub>CC</sub> 3.0–3.6 V recommended, 6 V abs max; D/R abs max V<sub>CC</sub> + 0.5 V; marking VP230 | Supply from the ESP32 3V3 pin (directly on Nodes 1/2, via the B+ rail on Node 3). Gate **G4**: chip marking reads VP230 and there is no 5 V-only module supply | Confirmed (IC); Provisional (module, G4) | N1-01, N2-01, N3-04 |
| C05 | p.4 §3 Node tables, column "ESP32 board pin" | Rows list "CANH" and "CANL" under *ESP32 board pin* | Misleading: CANH/CANL are transceiver pins and must never touch an ESP32 pin | E-TI | The ledger lists CANH/CANL only as transceiver endpoints. `ledger.py` rejects any CANH/CANL-to-ESP32 connection (negative test passed) | Confirmed | All node diagrams; bus diagram |
| C06 | p.4–5 §3 all "TBD GPIO – STOP" rows | No pin chosen for the OLED, LEDs, buttons or buzzer | Rev 1 could not be wired at all | E-ESP32, E-WROOM, E-ARD | Proposed and checked: LEDs green/yellow/red = GPIO25/26/27; buttons A/B = GPIO32/33 (internal pull-up, active low); buzzer drive = **GPIO13**; I²C 21/22. None is a flash, strapping, input-only or USB-serial pin (checked automatically) | Provisional (G2; no firmware yet uses them) | Node 3 diagram; scene 5 |
| C07 | (new) | — | Rev 1 never says that the 3V3 outputs of different nodes must stay separate. On a shared breadboard it is easy to join them through a rail, putting two regulators in parallel | Basic circuit principle | Explicit rule; Board A rails carry GND only. `ledger.py` rejects joined 3V3 nets (negative test passed) | Confirmed | Power-domain diagram; scenes 1, 4, 7 |
| C08 | p.5–6 §4 buzzer | "5V source – STOP until reviewed"; "select resistor and transistor"; no values | Topology right, but no values, no boot-state control and no 5 V source named | E-CALC, E-ESP32 | Low-side NPN: GPIO13 → 1 kΩ → base; 10 kΩ base→GND (keeps the buzzer silent while pins float at reset); emitter → GND; collector → buzzer −; buzzer + → **Node 3 VIN** (USB 5 V, no external supply, so no back-feed path); 1N4148 across the buzzer (cathode to +) only if it is electromagnetic | Provisional (values); **Blocked**: Q1 pinout (G10) | Node 3 diagram: N3-27..N3-35; Q1 leads dashed red |
| C09 | p.3 inventory "1 NPN transistor driver + base resistor" | Listed as if available | Not in the user's available-parts list | User inventory | Marked **REQUIRED EXTRA**: NPN (Ic ≥ 100 mA) and 1 kΩ. Recommended: 10 kΩ. Conditional: 1N4148. **Required tool**: DMM | Confirmed | Inventory (manual §1, scene 1) |
| C10 | p.3 inventory "DMM; optional magnifier" | DMM listed in Rev 1 but not in the user's inventory | Every gate needs one | — | DMM is a required tool | Confirmed | Scene 1 |
| C11 | p.3 "Tactile push buttons: four-leg switch pairs are internally connected; orient across breadboard center gap"; p.6 orientation sketch | "a typical 4-leg tactile switch connects each pair on the same side internally. Insert it over the breadboard center trench so pressing bridges the two sides" | Package-dependent and can be wrong. On many 6 × 6 mm switches the legs that straddle the trench are the **permanently connected** pair, so the "button" reads as always pressed | Geometry of a 4-leg SPST switch: two legs per contact, so diagonal legs always belong to different contacts | **Diagonal-leg rule**: GPIO → L1, GND → L3 (diagonal), whatever the orientation. Confirm with gate **G8** | Confirmed (rule); Provisional (G8 per part) | Parts sheet; N3-23..26; scene 5 |
| C12 | p.6 §4 OLED | "ESP32 3V3 → OLED VCC only if label permits; chosen SDA/SCL" | Pin order varies (GND-VCC vs VCC-GND), and the address is not recorded | Common module variants | Wire by **printed name** only (gate **G7**). Power from 3V3 only, so the pull-ups sit at 3.3 V. Record the address marking (0x78 → 0x3C) | Provisional (G7) | N3-10..13; parts sheet |
| C13 | p.7 §5 "Some transceiver modules include onboard termination… inspect and measure" | Correct, but no procedure or decision rule | With three modules each carrying 120 Ω, the bus reads 40 Ω. The user's inventory also includes two external 120 Ω | Vendor modules differ (some fixed, some jumpered) | Gate **G6**: measure CANH–CANL on each bare, unpowered module. Decision table: none onboard → fit RT1/RT2; onboard at an end node → omit that external resistor; onboard at Node 2 (middle) → **BLOCKED** until removed (row C-T2) | Provisional (G6); C-T2 Blocked if it occurs | Bus diagram; scene 2 and scene 6 |
| C14 | p.1, p.7 bus diagram | Node 3 drawn in the middle (N1 – N3 – N2) | Not wrong (Rev 1 allows any order), but with two breadboards and Nodes 1+2 on Board A, a middle Node 3 would make the trunk run A → B → A | Layout | Bus order **end A – N1 – N2 – N3 – end B**. RT1 at TRX1, RT2 at TRX3, none at TRX2 | Confirmed (design choice) | Bus diagram; placement plan; scene 6 |
| C15 | p.3 "Mount each ESP32 so its two pin rows straddle the center trench" | Assumes a fit | A 30-pin DevKit straddling an 830-point board leaves at most one free hole per pin, and some clones leave none | Board width varies | Gate **G3**: confirm ≥ 1 free hole per pin; otherwise bridge two boards or use F-M jumpers | Provisional (G3) | Placement plan; scenes 3–5 |
| C16 | p.3 "3 USB power/data connections… No unknown external 5 V injection" | OK | Rev 1 did not say where the buzzer's 5 V comes from | — | No external 5 V anywhere. The buzzer uses Node 3's own VIN on USB; measure it first (gate **G12**, 4.4–5.25 V); VIN pins of different nodes are never joined | Provisional (G12) | N3-35; power diagram; scene 8 |
| C17 | (new) | — | Boards may arrive pre-flashed with firmware that drives arbitrary GPIOs (for example GPIO16 as an output against the transceiver's R output) | General ESP32 practice | Flash each **bare** board with its bring-up firmware before wiring (Node 1 `node1`, Node 2 `legacy_sketch`, Node 3 `monitor`) | Confirmed (procedure) | Scene 1 "Flash before wiring" |
| C18 | p.9 §7 "First power-up order: … 6) Power down all; reconnect the bench bus" | Requires the trunk to be disconnected during single-node power-up | Overly conservative. TI: "an unpowered node does not disturb the bus" (SLOS346O §10.3). Pulling and re-inserting trunk wires adds wiring-error risk | E-TI §10.3 | The trunk stays wired; one node on USB at a time; the others are unplugged | Confirmed (IC behaviour) | Scene 8 |
| C19 | p.10 §8 stage C "Known test frame exchanged" | No firmware named | Repo node1/node2 targets have TX **disabled**; only `sketch_node2_test` transmits (0x201/0x202/0x203 every 1 s, 0x210 every 500 ms). `twai_transmit` returning OK ("Sent CAN ID") only means the frame was queued | E-FW | Two-node evidence = Node 1 printing JSON `"type":"frame"` lines with those IDs and low error counters. "Sent" alone is not evidence | Confirmed | Scene 9 |
| C20 | p.10 §8 stage D "Power monitor in documented listen-only mode if supported" | Generic | The `node3` target refuses to start CAN by design. The `monitor` target is listen-only on 17/16 at 500 kbit/s | E-FW | Node 3 hardware runs `firmware/monitor` for bring-up. Reconciling the `node3` and `monitor` targets is an open software task | Confirmed | Scenes 1, 8, 9 |
| C21 | p.1 "Project roles … role-specific firmware supplied separately" | Implies firmware exists | No firmware drives the OLED, LEDs, buttons or buzzer. No motor (RPM/temperature) or battery (V/I/SoC) simulation, heartbeat or fault injection exists in the current targets (only fixed test frames in the legacy sketch) | grep of `firmware/` for GPIO21/22/25/26/27/32/33/13: no hits | Stated plainly in the manual and video; peripheral functional tests marked **BLOCKED (no firmware)** | Confirmed | Scenes 1, 9, 10 |
| C22 | p.9 §7 table "Power shorts… No persistent near-zero short" | OK | No procedure for VIN, and no rule that USB must be unplugged for resistance tests (the PC ground joins the nodes) | — | Rail checks per node including Node 3 VIN; all USB unplugged for every resistance test | Confirmed | Scene 7 |
| C23 | p.2 "Important board cautions" | Strapping pins GPIO0/2/5/12/15 | Correct | E-ESP32 | Kept. D12 (GPIO12) sits next to the chosen D13, so the manual and video warn that it must stay empty | Confirmed | N3-27 narration |
| C24 | p.6 §4 LEDs | "GPIO → 220 Ω → anode; cathode → GND"; current formula | Correct; values not computed | E-CALC | 5–7 mA per LED stated | Confirmed | Scene 5 |
| C25 | p.7 meter-reading table | 60 / 120 / 40 / open / 0 Ω interpretations | Correct | E-CALC | Kept, with a 57–63 Ω tolerance note | Confirmed | Scene 7 |
| C26 | p.1–12 general | "Revision 1.0 … no physical hardware inspection" | Correct and kept | — | Rev 2 is labelled **2.0-draft (not final)** because blocked items remain | Confirmed | Title card; manual cover |
| C27 | (repo) `docs/hardware-status.md` row "Monitor CAN TX/RX … Monitor board unknown" | Monitor treated as a 4th board | The user's build has three boards. Node 3 *is* the monitor | User brief | The ledger treats Node 3 hardware = monitor firmware. `docs/hardware-status.md` should be updated once a bench result exists | Provisional | — |

## Remaining blocked items

1. **Q1 transistor pinout** (N3-28, N3-29, N3-30, N3-31, N3-32): needs the part number and its own datasheet (gate G10).
2. **N3-35 buzzer supply**: deferred until G10, G11 and G12 pass.
3. **C-T2**: only if Node 2's module has an onboard terminator. Removal method needs a photo.
4. **Peripheral functional tests** (OLED, LEDs, buttons, buzzer): blocked on firmware that does not exist yet.
5. **Every PROVISIONAL row** stays provisional until its gates are recorded on the sign-off sheet by the builder.
