Naveen-kumar14/CanScope/(commit log)

2026-10-13 firmware: add shared CAN transport foundation
    Portable config validation, raw frame model and JSON-line encoder,
    transmit gate, protocol registry/decoder and diagnostics banner, plus the
    ESP32 TWAI transport and shared node runtime. TX is gated and refused in
    listen-only mode; bus-off is reported, never auto-recovered.
2026-10-16 docs: add canonical wiring ledger with safety and firmware-pin validation
2026-10-16 docs: generate wiring diagrams and Rev 2.0-draft physical build manual from the ledger
2026-10-16 video: add ledger-driven build video storyboard, narration and renderer
2026-10-16 validation: add Rev 1 correction register, wire coverage checklist and final review
    [validate.py]
2026-10-17 protocol: add single-source CANScope protocol v1 with generator, codec and serial link
    protocol/canscope_protocol.json generates the firmware header, the dashboard
    module and shared golden vectors; C++ codec, exact decimal parser, command
    line parser and ack/hello encoders with host tests.
2026-10-17 firmware: implement Node 1 motor and Node 2 battery ECUs
    Telemetry and heartbeat schedule, validated set/profile/fault commands with
    acks, demo fault injection, operator-triggered bus-off recovery restart.
2026-10-17 firmware: implement Node 3 CANScope monitor with independent fault detection
    Frame validation, heartbeat/telemetry timeouts, monitor bus-off vs ECU loss,
    thresholds with hysteresis, SSD1306 OLED pages, LEDs, debounced buttons and a
    build-gated buzzer; demo-fault detection contract tests.
    [main.cpp, monitor_hw_config.h, monitor_ui.cpp, monitor_ui.h]
2026-10-17 tools: PlatformIO Core wrapper and Windows flashing guide
    Add tools/setup-pio.cmd (one-time PlatformIO Core 6.2.0 install into
    C:\canscope-pio) and tools/pio.cmd (runs it without PATH changes), plus
    docs/flashing-windows.md with build, COM port, upload and serial monitor
    steps for Node 1, Node 2 and the Node 3 monitor. Pin *.cmd to CRLF.
    No firmware or build configuration changed.
2026-10-23 firmware: start-up transceiver echo check and status line buffer fix
    Each node pulses CAN TX before installing TWAI and checks the transceiver
    echoes it on RX (skipped in listen-only). The result is printed in the
    banner and reported as transceiverCheck in every status line, to locate
    TX/RX/Rs/power wiring faults on one bare board.
    The worst-case status line (~500 chars) exceeded the 384-byte buffers,
    so it could be silently dropped; buffers raised to 640 with a host test.
    [can_transport.cpp, can_transport.h, ecu_runtime.cpp, main.cpp, node_runtime.cpp, test_can_transport.cpp, transceiver_check.cpp, transceiver_check.h]
2026-10-23 dashboard: strict frame/status validation and serial lifecycle fixes
    - reject status lines with missing or mistyped counters instead of 0
    - reject frames whose payload does not match DLC/remote flag
    - close a lost port so the automatic reopen after replug succeeds
    - generation guard so a stale open() cannot leave two handles
    - forgetPort reports whether browser permission was really revoked
    - bind command acks to serial link and device boot; 6-char crypto tag
2026-10-25 dashboard: connect fresh on every start
    Each session begins with no port cards: previously granted ports are no
    longer listed via getPorts() or opened on replug, and disconnect() clears
    the in-memory entries. Browser serial permissions are kept (only Forget
    port revokes one), so the boards are quick to pick again. "Connect known
    ports" becomes "Reconnect closed ports" for ports picked this session.
2026-10-25 firmware: host-testable transceiver echo check line
    The echo check was missing from Node 1's serial output because the board
    runs a build from before b2f32aa (local images dated 2026-10-17 contain
    neither the banner line nor the transceiverCheck status field; the
    version stayed 1.0.0). The source was already correct.
    Move the "# CAN transceiver echo check: <name> - <hint>" line into
    emit_transceiver_check() so ECU and monitor share one formatter, and test
    it on the host for every result without truncation. Dashboard tests now
    cover status lines with each transceiverCheck value, without the field
    (old firmware, shown as "not reported"), and the banner line as a
    diagnostic only. Output text a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
    [diagnostics.cpp, diagnostics.h, ecu_runtime.cpp, main.cpp, test_diagnostics.cpp]
